wolfidan/callisto/output/nightscan/scan-results/full-sky-scan_interpolated_2025-04-20.png

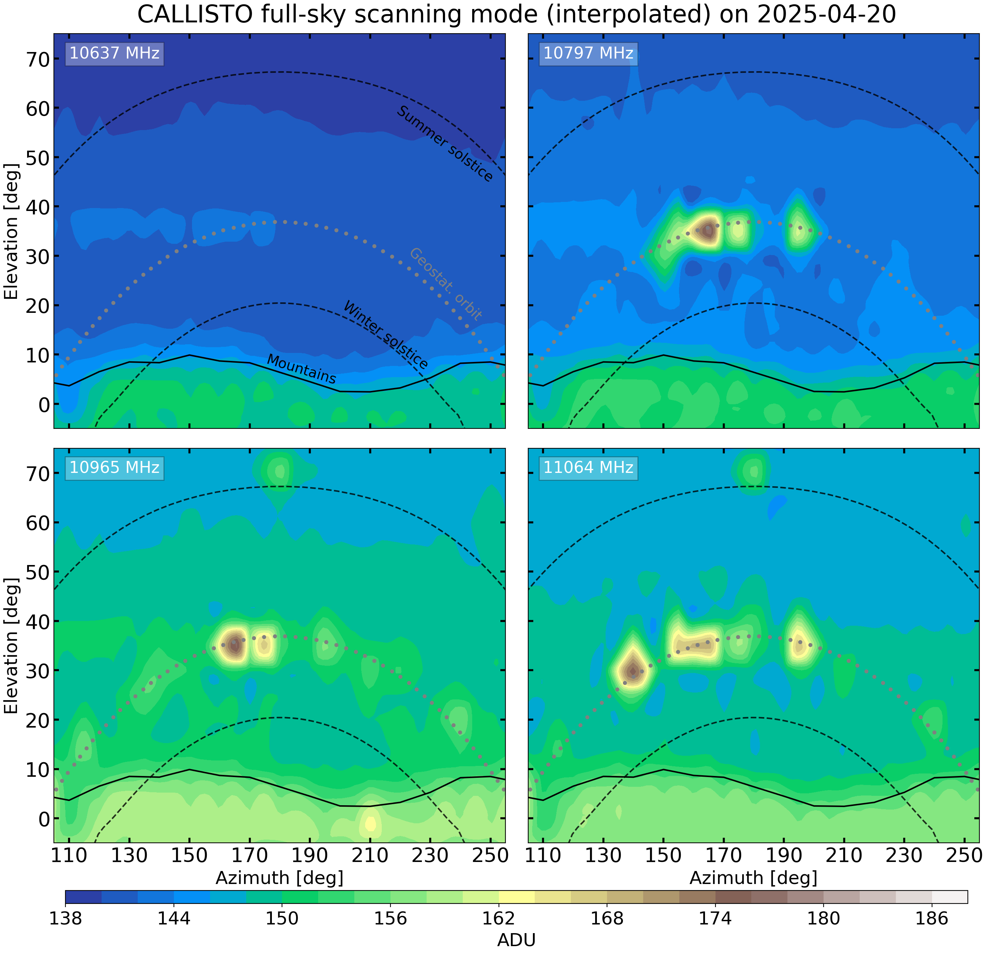
output/nightscan/scan-results/full-sky-scan_interpolated_2025-04-20.png
