wolfidan/callisto/readme.md

# X-band Radio Telescope (XRT) in Locarno-Monti: CALLISTO spectrometer for solar flux monitoring

A forthcoming scientific publication will address the main aspects of the instrument's capabilities and performance.
