wolfidan/callisto/doc/Documents/computerstuff.docx

# Computer related and other stuff

Computer name: XRT
User name: SwissMeteo
Password: xrt

MS-account: none
OneDrive: not yet enabled

Security questions:
- 1st pets name: Kati
- Childhood nickname: Bruno
- First school: Kurz

Windows updates: Paused until ~20/12/2023; For manual update, close all applications first.

Installed tools:
- Anaconda Python3
- Arduino-Driver
- System Scheduler ssfree.exe
- PUTTY
- ActivePERL
- Java RunTimeSystem
- CALLISTO and related tools (C++ and Python) [CallistoInstaller_V22.zip + Callisto_V125.zip]
- AnyViewer: 719 915 680 password XrT-2023
- AnyDesk: 1 568 878 401 password XrT-2023

Change of autostart: Win R shell:startup

Two times per year change direction for cold sky calibration +/-10°, see path geostationary satellites

Do not forget to check updates and to restart computer including CALLISTO

In case last FIT-file of the day is not complete, delete it. Otherwise calibration process may die

Do not forget to backup applications and system
