wolfidan/callisto/doc/Documents/SatFinderOrNotSatFinder.pptx

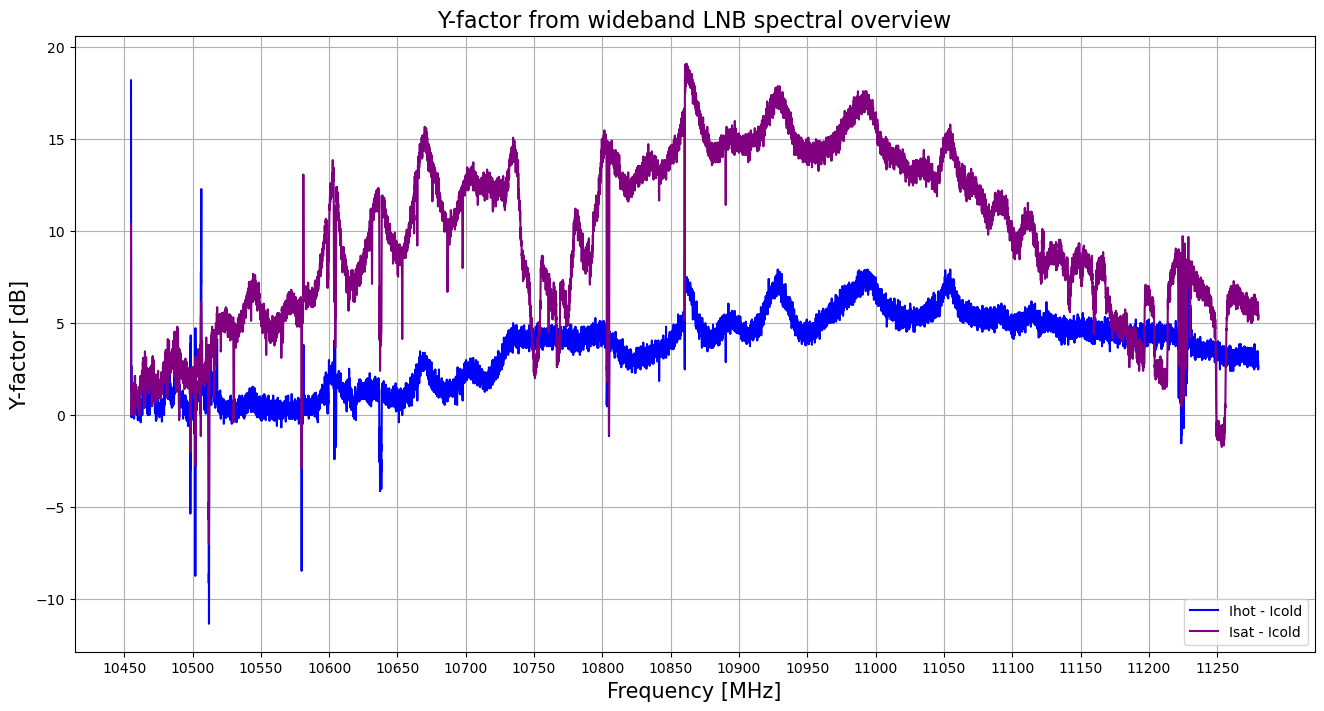
[picture p3: figure]
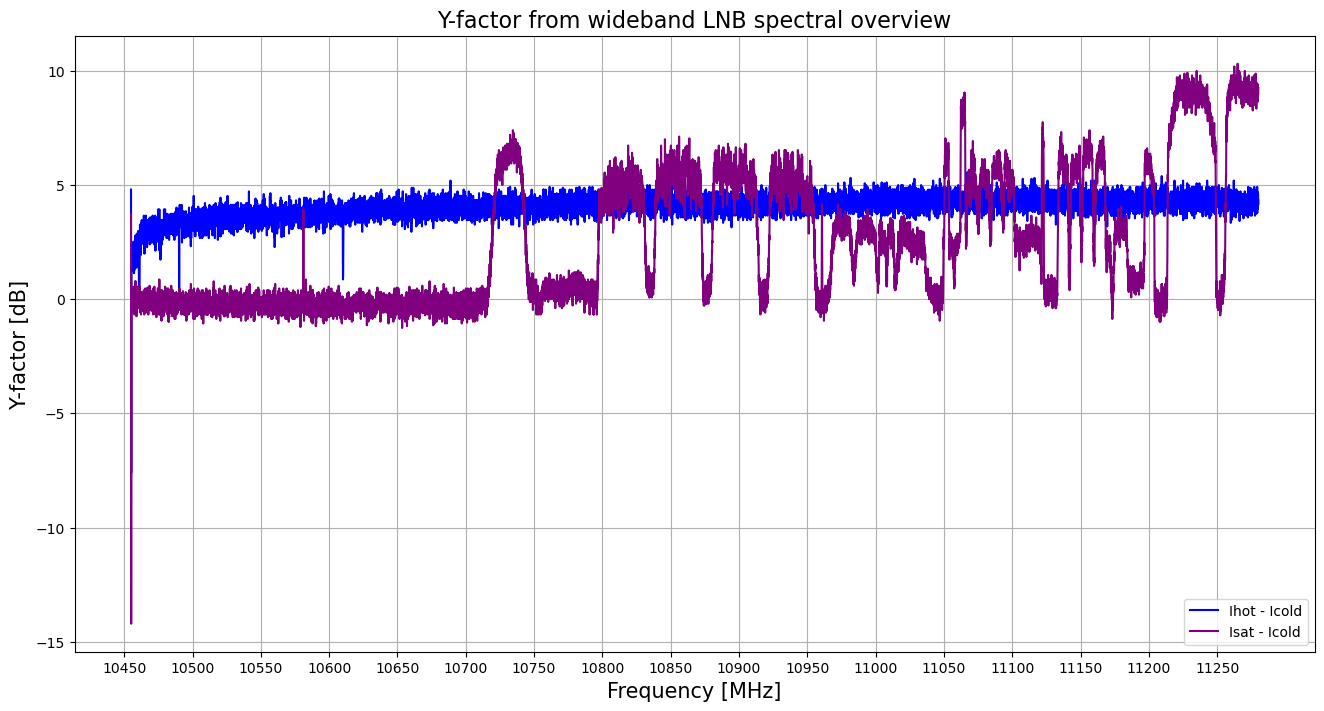
[picture p4: figure]
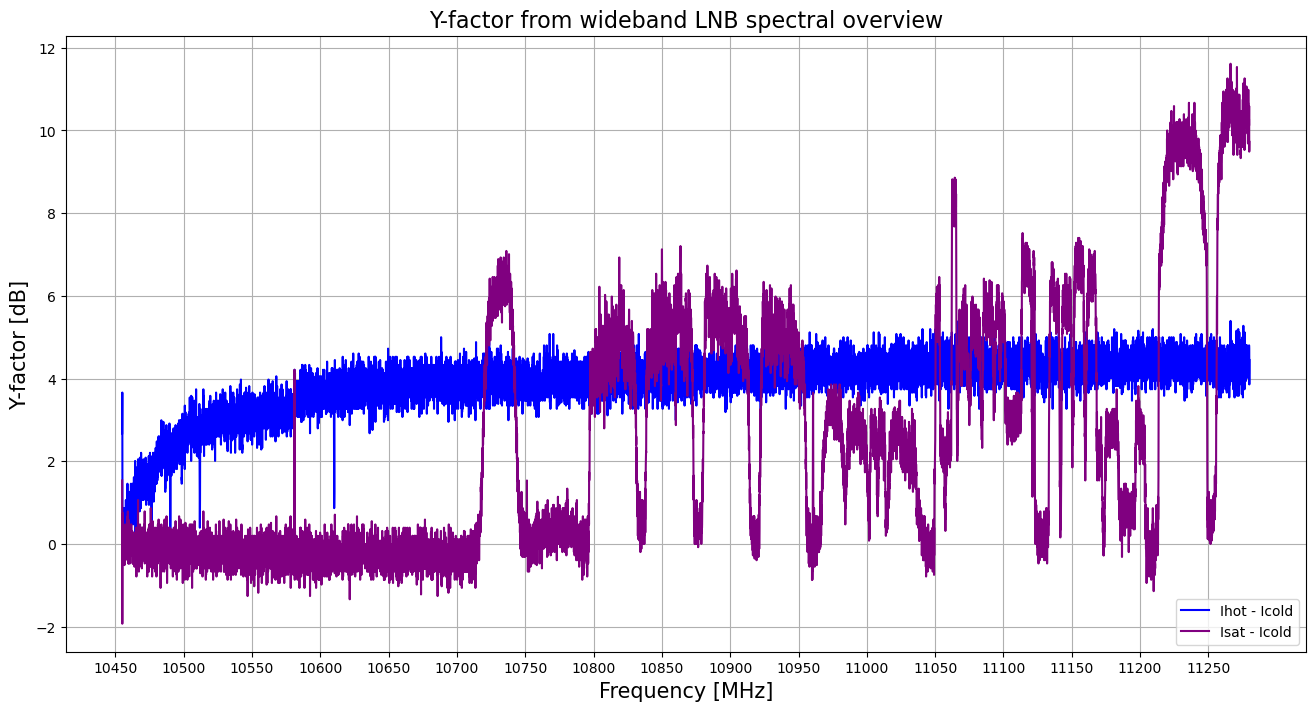
[picture p5: figure]

With SAT-Finder, gain 122d No SAT-Finder, gain 82d No SAT-Finder, gain 82d, -10 dB ATT

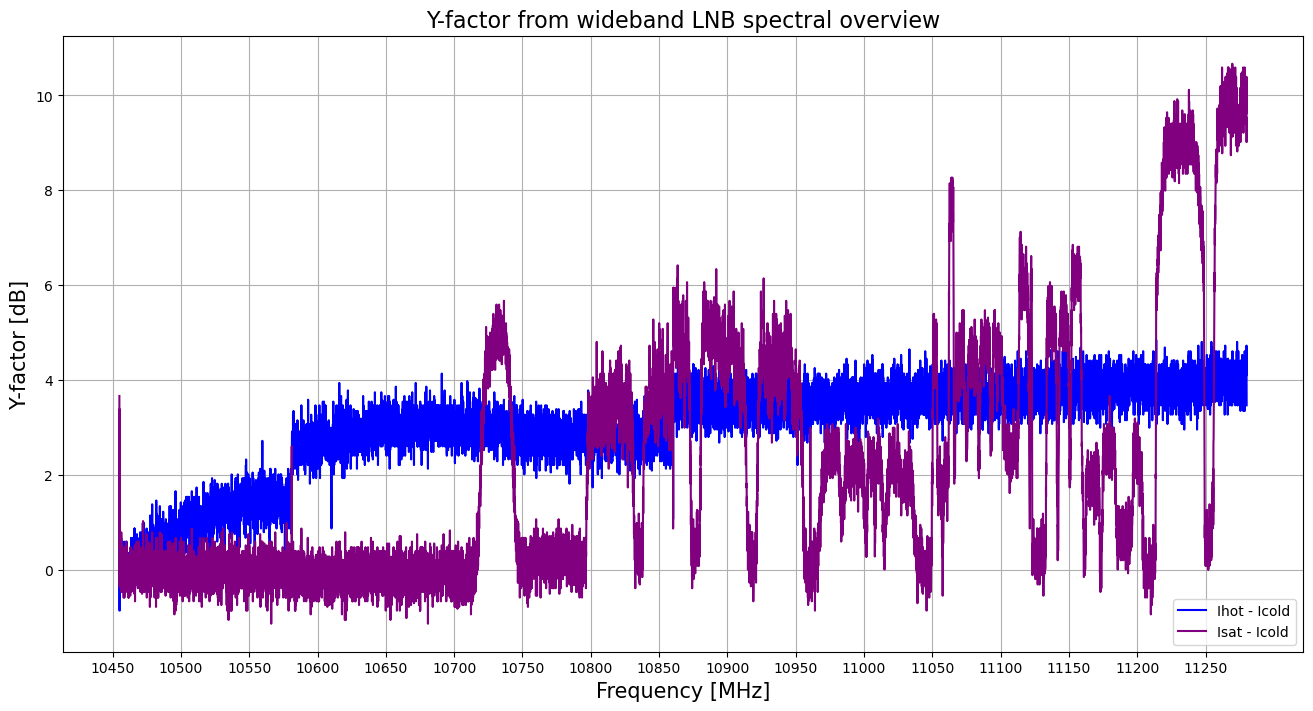
[picture p6: figure]
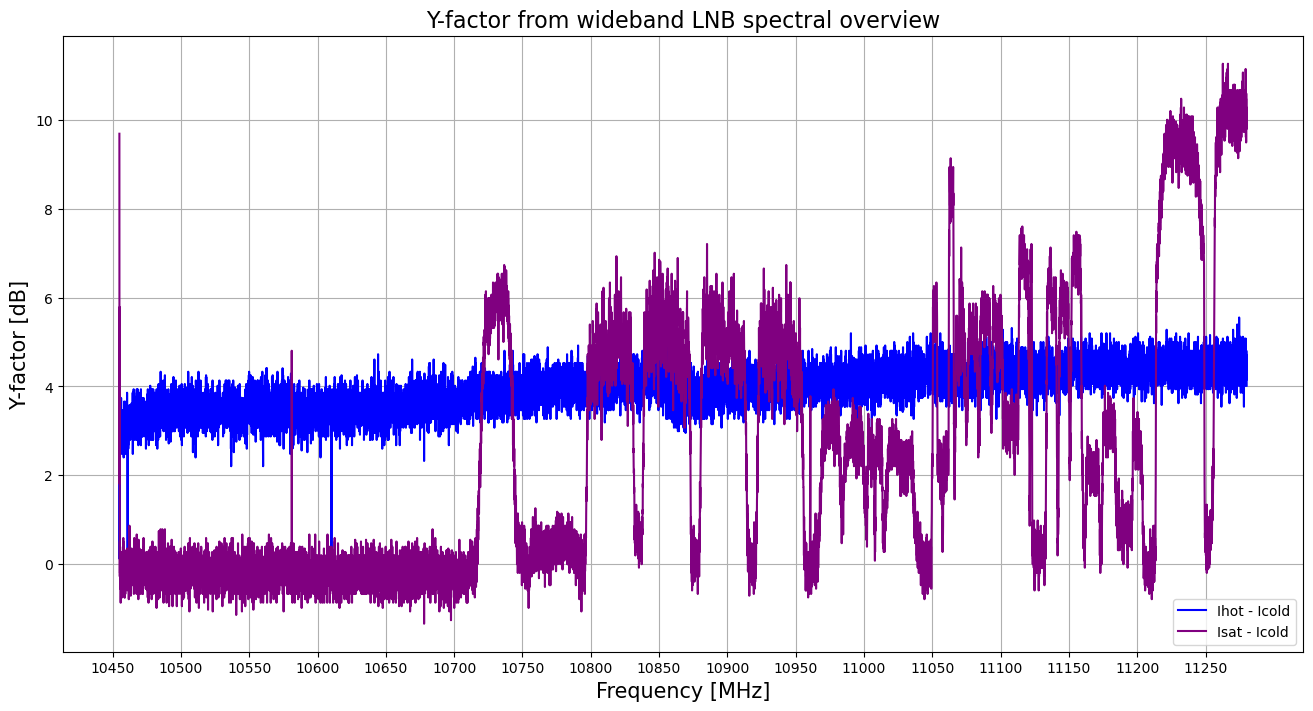
[picture p7: figure]

SAT-Finder advantage:
Higher Y-factor
SAT-Finder disadvantage:
Only at dedicated frequencies
No SAT-Finder advantage:
Flat spectrum
No SAT-Finder disadvantage:
Lower Y-factor

No SAT-Finder, gain 82d, -20 dB ATT No SAT-Finder, gain 123d, -20 dB ATT

Y-factor Sky-Ground in blue, Y-factor Satellite-Ground in purple

## Slide 2

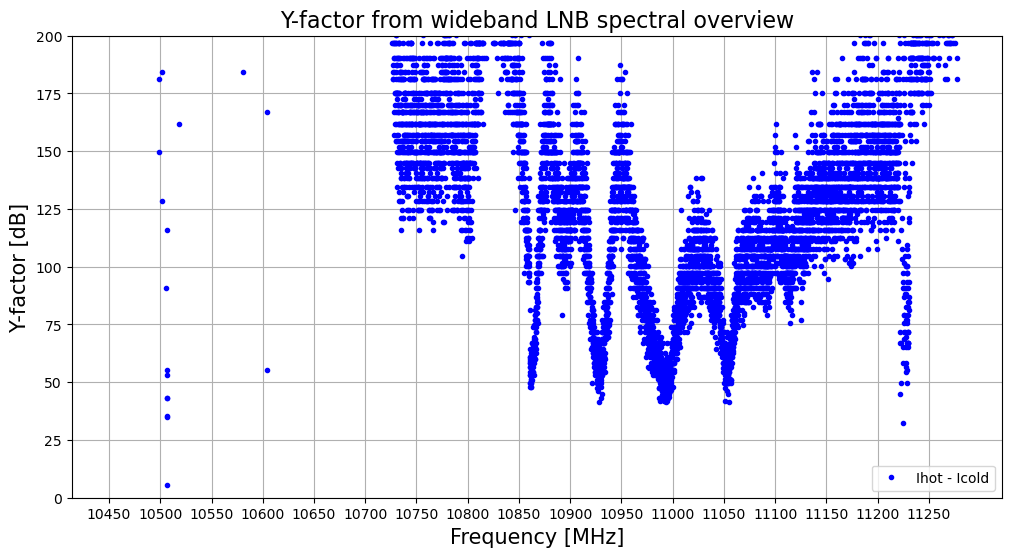
[picture p8: figure]
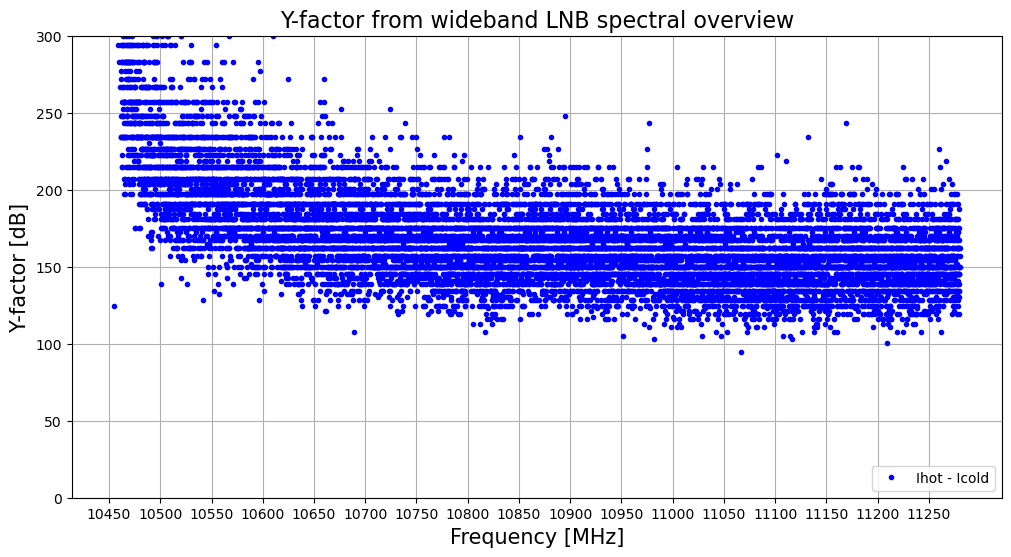
[picture p9: figure]
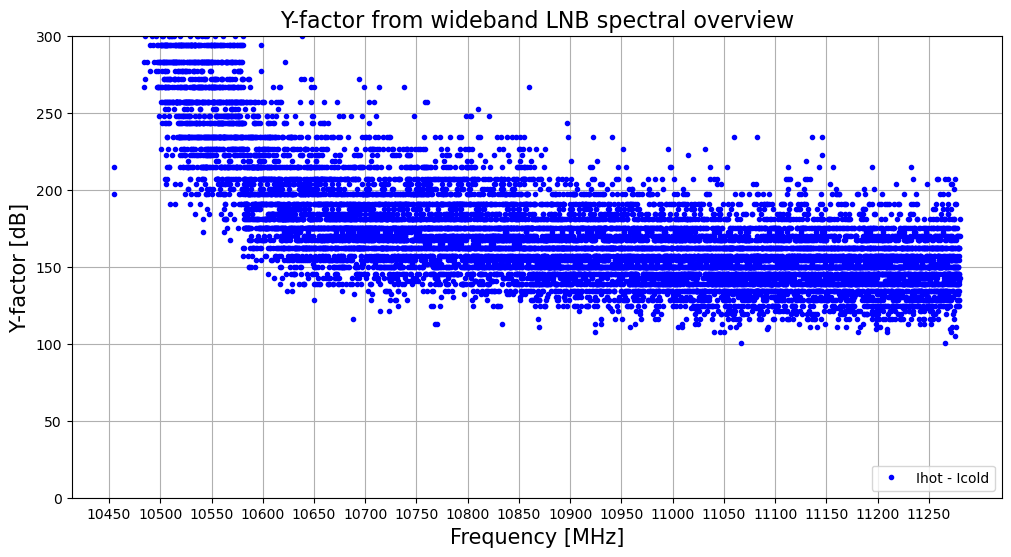
[picture p10: figure]

With SAT-Finder, gain 122d No SAT-Finder, gain 82d No SAT-Finder, gain 82d, -10 dB ATT

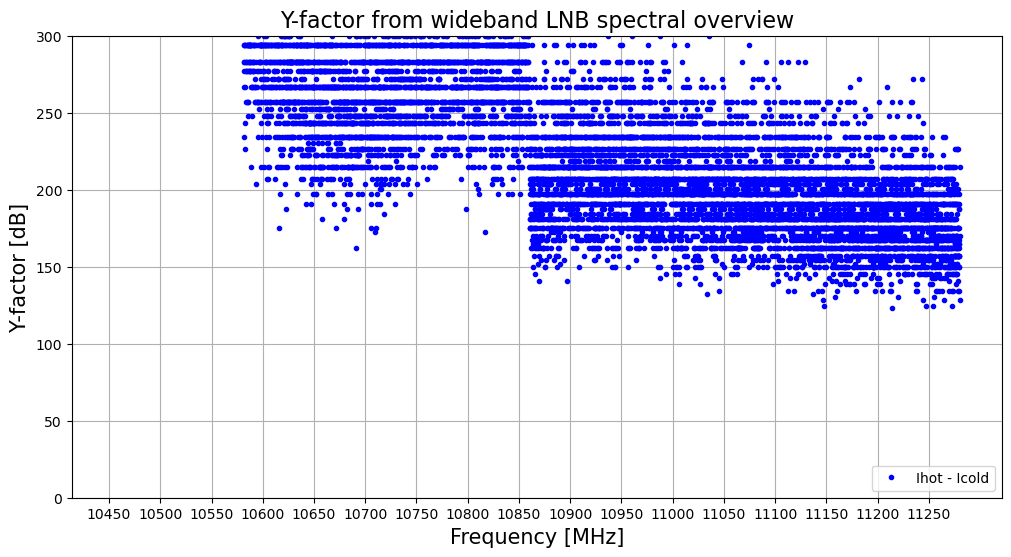
[picture p11: figure]
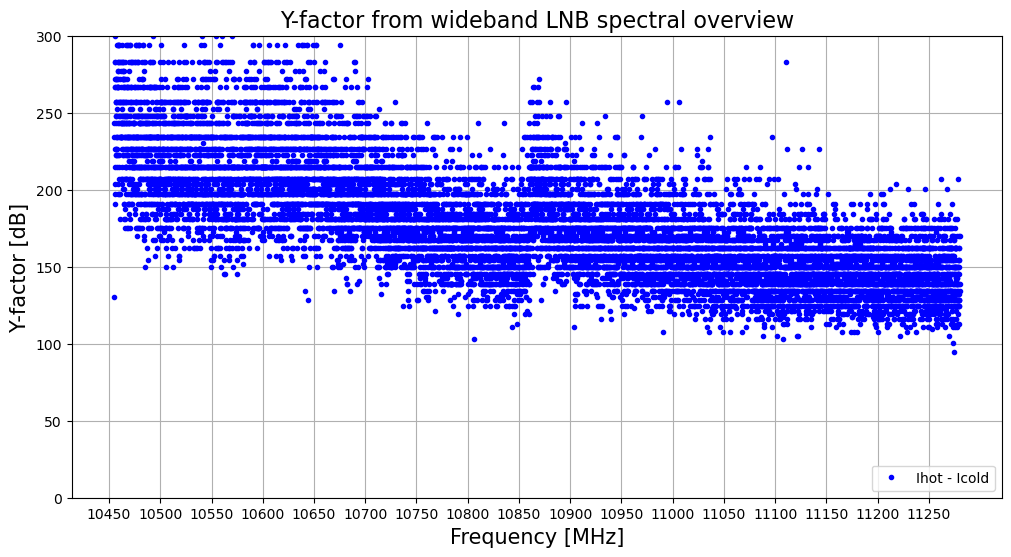
[picture p12: figure]

Instrument noise temperature
Is best WITH SAT-Finder,
although only at dedicated frequencies
Which need to be found out for a
specific configuration.

No SAT-Finder, gain 82d, -20 dB ATT No SAT-Finder, gain 123d, -20 dB ATT

System temperature: Sky/Ground
