wolfidan/callisto/scripts/control/moontracking/configmoon.docx

# Description of the configuration file/parameter configmoon.ini

The file shown below contains all variables and constants required in the Python script moonpos_AZI_ELE.py. File shall be edited with a simple ASCII-Editor such as notepad.

#
# Configuration file for python sun-tracker
# Author: Chr. Monstein
# Date: 2023-08-24
# Do not add comments at the end of any parameter!
#
#------------------------------------------------------------------------------

# Location parameter

[Location]

longitude = 8.755948 # Longitude of telescope in decimal degree, positive east
latitude = 47.20329 # Latitude of telescope in decimal degree, positive north
elevation = 414 # Elevation of telescope above sea-level in meters
temperature = 32 # Ambient temperature in Celsius degree to compensate refraction
pressure = 900 # Atmospheric pressure to compensate refraction in mbar

# Tracker parameter (rotors and interface)

[Tracker]

MaxRange = 77 # Maximum and fixed range of the rotor as +/-, in total 154°
AziMin = 80.0 # Minimum azimuth to avoid obstructions in the east, such as neighbor’s house
AziMax = 250.0 # Maximum azimuth to avoid obstructions in the west, such as neighbor’s house
EleMin = -12.0 # Lowest elevation, usually required for ground calibration Thot of about 300 kelvin
EleMax = 90.0 # Highest elevation which one wants to reach, usually for sleeping position in zenith
AziPark = 180.0 # Azimuth of telescope in sleeping mode during the night. Can be used to observe the Moon or the Sun in transit mode
ElePark = 90.0 # Elevation of telescope in sleeping mode during night. Can be used to observe the Moon or the Sun in transit mode

aziref = 165.7 # Azimuth reference, depends on observing window, usually somewhere in the south
eleref = 42.5 # Elevation reference, depends on observing mode, usually below track of the sun

azidir = -1.0 # Direction of rotation azimuth rotor, negative to the east
eledir = 1.0 # Direction of rotation elevation rotor, positive to the zenith

planecorr = 0.0184 # Factor to correct for tilted azimuth plane, ideally 0.0
Correction is performed as a linear approximation:
true_elevation = calculated_elevation – planecorr*azimuth
The factor planecorr can be found by rotating azimuth from -75° … 75° in steps of ~2° …5° and measuring elevation with a inclinometer. Then put azimuth and elevation into EXECL, add linear plot and remember gradient. If east is higher in elevation than west, then gradient planecorr is > 0.

MyComport = COM13 # Communication port via USB, use device manager to find out. Arduino driver required

# Calibration related parameter

[Calibration]
EleGnd = -8.0 # Position slightly below horizon to get Thot of about 300 kelvin
dEleCali = -10.0 # Deviation from sun-tack to get cold sky for calibration of about 12 kelvin

# Swiching parameter

[TelescopeSwitching]

Hot = 0,1,2,15,16,17,30,31,32,45,46,47 # AT those minutes, telescope moves to ground (~300 kelvin)

Cold = 3,4,5, 9,10,11,18,19,20,24,25,26,33,34,35,39,40,41,48,49,50,54,55,56 # A few degree below moon to get cold sky (~12 kelvin)

Src = 6,7,8,12,13,14,21,22,23,27,28,29,36,37,38,42,43,44,51,52,53,57,58,59 # Telescope tracks moon
Do not add more values as it takes time to scan and we have only 60 minutes available for the whole scan until the next scan is triggered via system scheduler ssfree.exe (or via crontab).
