wolfidan/callisto/doc/Documents/datagram.pptx

Datagram CALLISTO

Option:
do.bat + ftp-gz.pl
upload to FHNW

callisto.cfg
scheduler.cfg

ssfree.exe
Every 15 min.

Callisto.exe
C++

Java Viewer or
RappViewer or FV.exe
Manual operation

PlottAndCalibratefromFIT-loop.py

PlottAndCalibrateLC-4Hz.py

Real time

15 minutes

*.fit

On request

OVS*.prn

10…40 sec

LC*.txt

LOG*.txt

Callisto-gain-sweep.py
ReadPlot:OVS.py

Notepad, Excel,
Wordpad, …

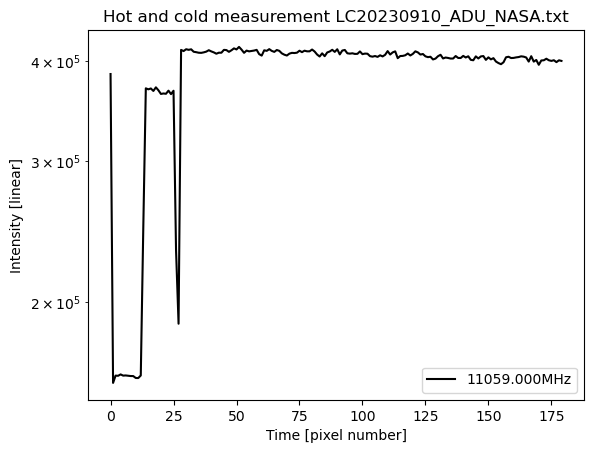
[picture p28: figure]
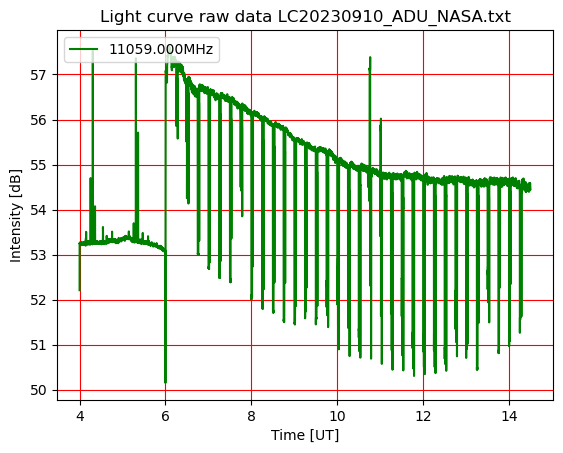
[picture p29: figure]
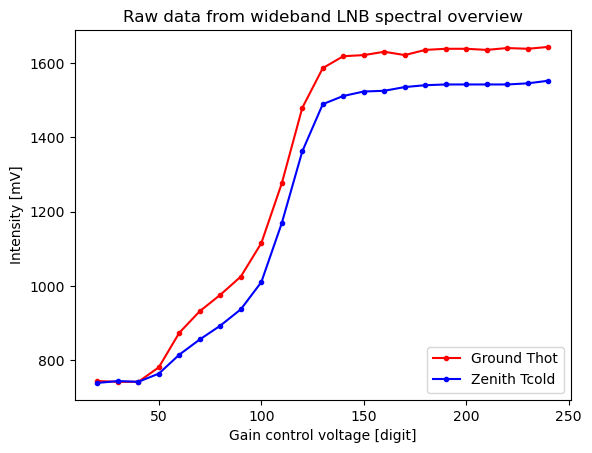
[picture p30: figure]

## Slide 2

Datagram DiSEqC Tracker

configsun.ini or
configmoon.ini

sunpos_AZI_ELE.py
or
moonpos_AZI_ELE.py

ssfree.exe
Every minute

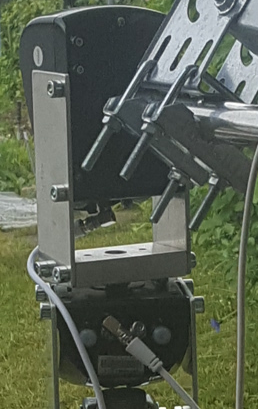
[picture p31: figure]

USB

DiSEqC
interface

PlotDiSEqC.py

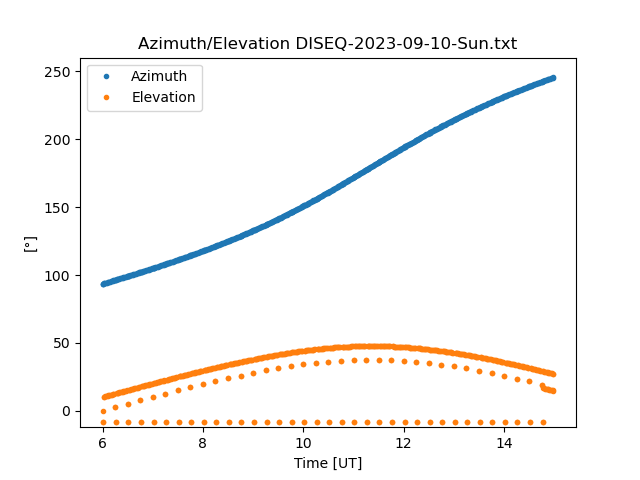
[picture p32: figure]

DISEQC*.txt

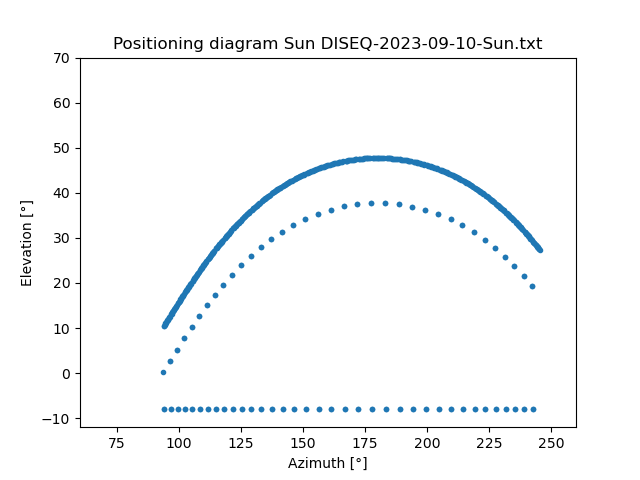
[picture p33: figure]
