wolfidan/callisto/scripts/control/suntracking/Python calls in System Scheduler ssfree.docx

Python calls in System Scheduler ssfree.exe

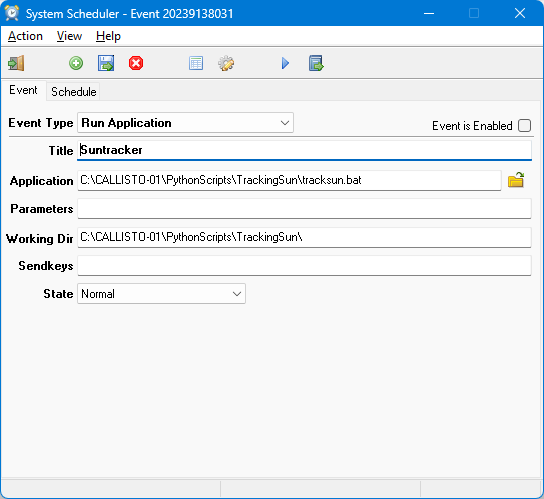
[picture p34: figure]
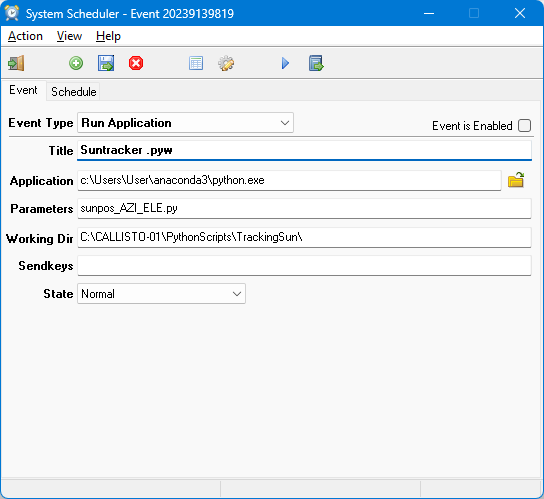
[picture p35: figure]
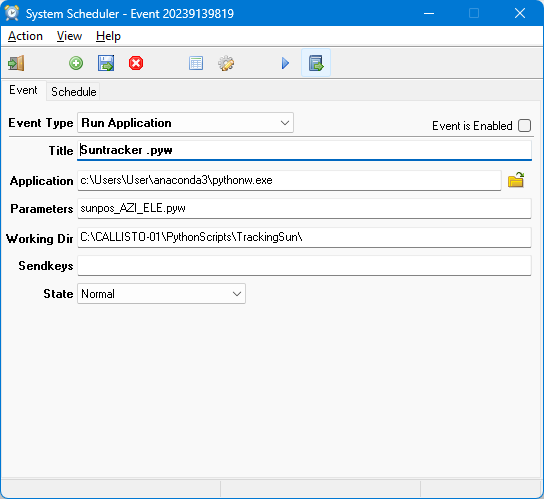
[picture p36: figure]
