wolfidan/callisto/doc/Screenshot_callisto_installation.png

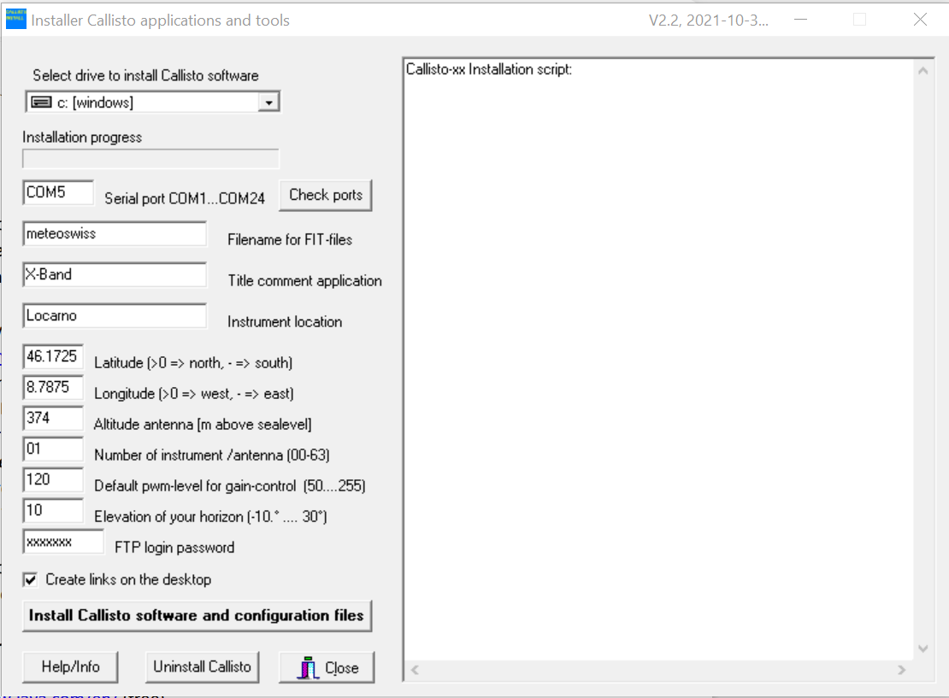
doc/Screenshot_callisto_installation.png
