wolfidan/callisto/doc/calibration/table_pointing-offsets.csv

# table listing the pointing offsets estimated by checking the maximum of the
# solar flux with callisto.
# The table includes the following entries:
# - datetime: date and time measured in UT
# - phi_sky & delta_sky [deg.]: azimut and elevation angles with the sky reference system
# - aziref & eleref [deg.]: azimut and elevation angles with the rotor reference system
# - sigma_azi & sigma_ele [deg.]: one sigma tolerance for aziref and eleref
# - freq [MHz]: at which the pointing offsets have been estimated
datetime_UT | phi_sky | delta_sky | aziref | eleref | sigma_azi | sigma_ele | freq
2024-12-03T12:53 | 203.9 | 18.12 | 181.3 | 60.2 | 0.5 | 0.2 | 609.875
2024-12-03T14:39 | 203.9 | 18.12 | 181.3 | 60.2 | 0.5 | 0.2 | 609.875
2024-12-04T09:50 | 158.7 | 18.74 | 181.6 | 59.6 | 0.3 | 0.2 | 609.875
2024-12-09T09:50 | 158.7 | 18.74 | 181.6 | 59.6 | 0.5 | 0.3 | 609.875
2024-12-09T11:33 | 158.7 | 18.74 | 181.6 | 59.6 | 0.5 | 0.3 | 609.875
2024-12-09T15:35 | 158.7 | 18.74 | 181.6 | 59.6 | 0.5 | 0.3 | 609.875
2025-03-03T14:45 | 158.7 | 18.74 | 181.0 | 60.8 | 0.5 | 0.3 | 10640
2025-03-05T14:30 | 158.7 | 18.74 | 181.5 | 60.3 | 0.5 | 0.3 | 10640
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
