wolfidan/callisto/doc/calibration/Tcold/Tcold_look_up_table.csv

# Atmospheric noise temperature [K] values for the Tcold measures
# These values have been taken from here
# https://descanso.jpl.nasa.gov/propagation/Ka_Band/JPL-D32584_1.pdf
# The Tcold value depends on the atmospheric condisions | such as clouds | atmospheric
# gasses | rain | and so on. Therefore | here we use these tabulated values to apply a first
# order correction (rather than the fixed value at 12 K).
#
# The value of the Tcold temperature depends on the frequency | elevation and the weather
# conditions | therefore in the table we include the following columns
# - freq: frequency in GHz
# - elev: elevation in degrees
# - cond: weather conditions | if 'clear' or 'cloudy'
# - AH: absolute humidity in g/m3
# - CL: columnar liquid in kg/m2
# - Tcold: estimate of the Tcold temperature in K
freq | elev | cond | AH | CL | Tcold
10 | 90 | clear | 15 | 0.5 | 4.7
10 | 90 | cloudy | 15 | 0.5 | 7.33
10 | 45 | clear | 15 | 0.5 | 6.62
10 | 45 | cloudy | 15 | 0.5 | 10.30
10 | 30 | clear | 15 | 0.5 | 9.32
10 | 30 | cloudy | 15 | 0.5 | 14.46
10 | 20 | clear | 15 | 0.5 | 13.52
10 | 20 | cloudy | 15 | 0.5 | 20.89
10 | 10 | clear | 15 | 0.5 | 25.89
10 | 10 | cloudy | 15 | 0.5 | 39.56
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
