wolfidan/callisto/output/nightscan/scan-results/full-sky-scan_2025-03-22.png

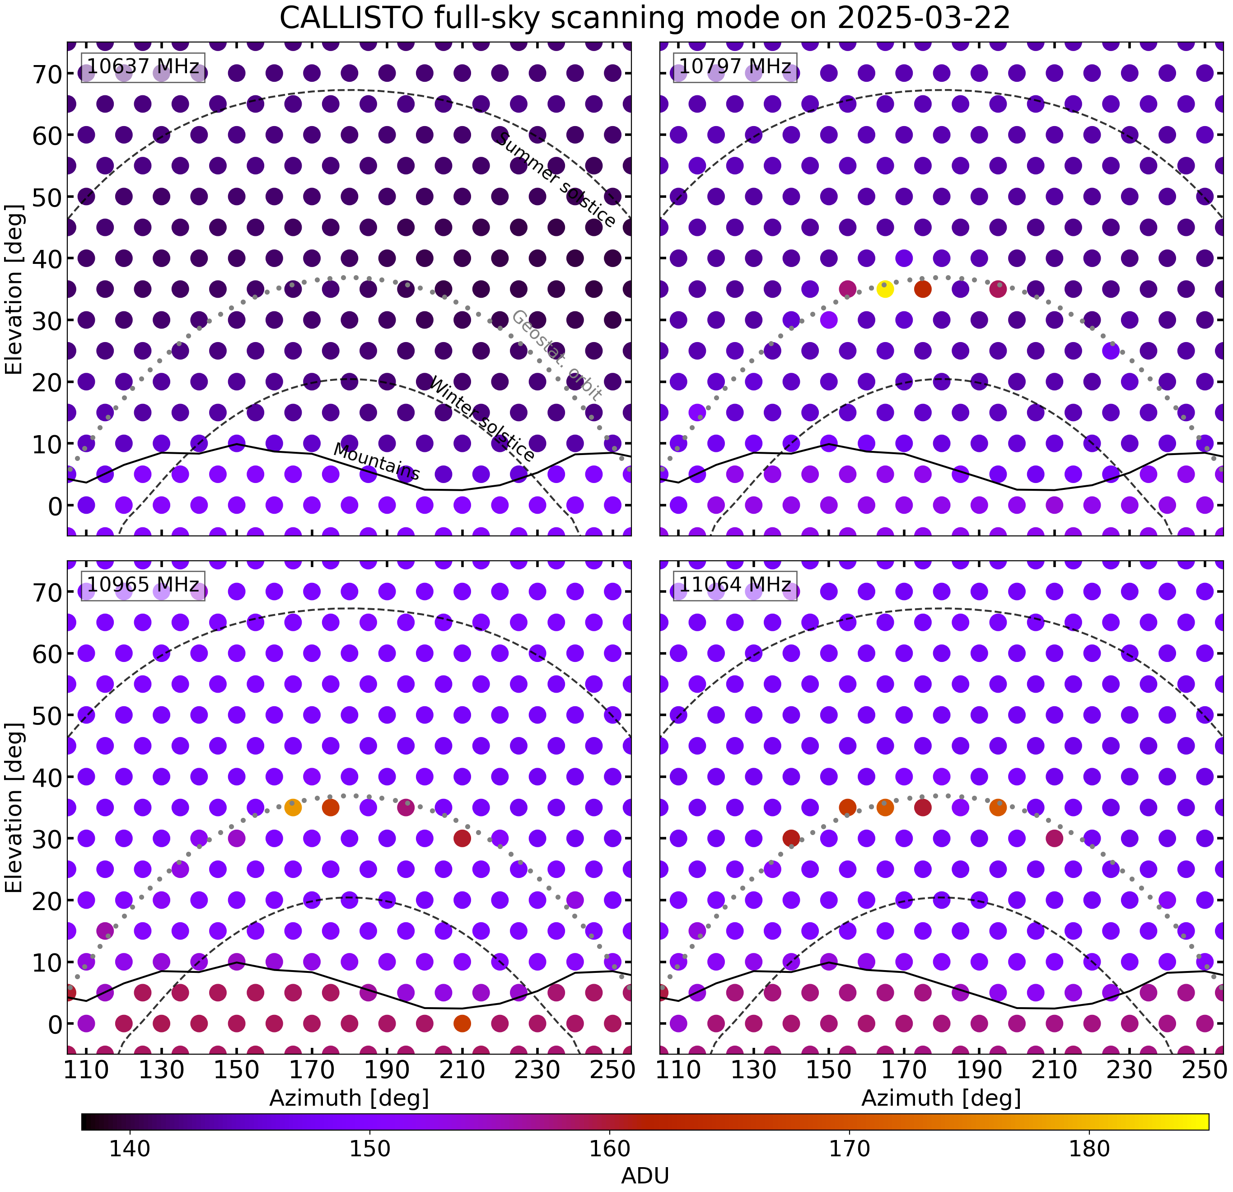
output/nightscan/scan-results/full-sky-scan_2025-03-22.png
