wolfidan/callisto/output/nightscan/scan-results/full-sky-scan_2025-03-24.png

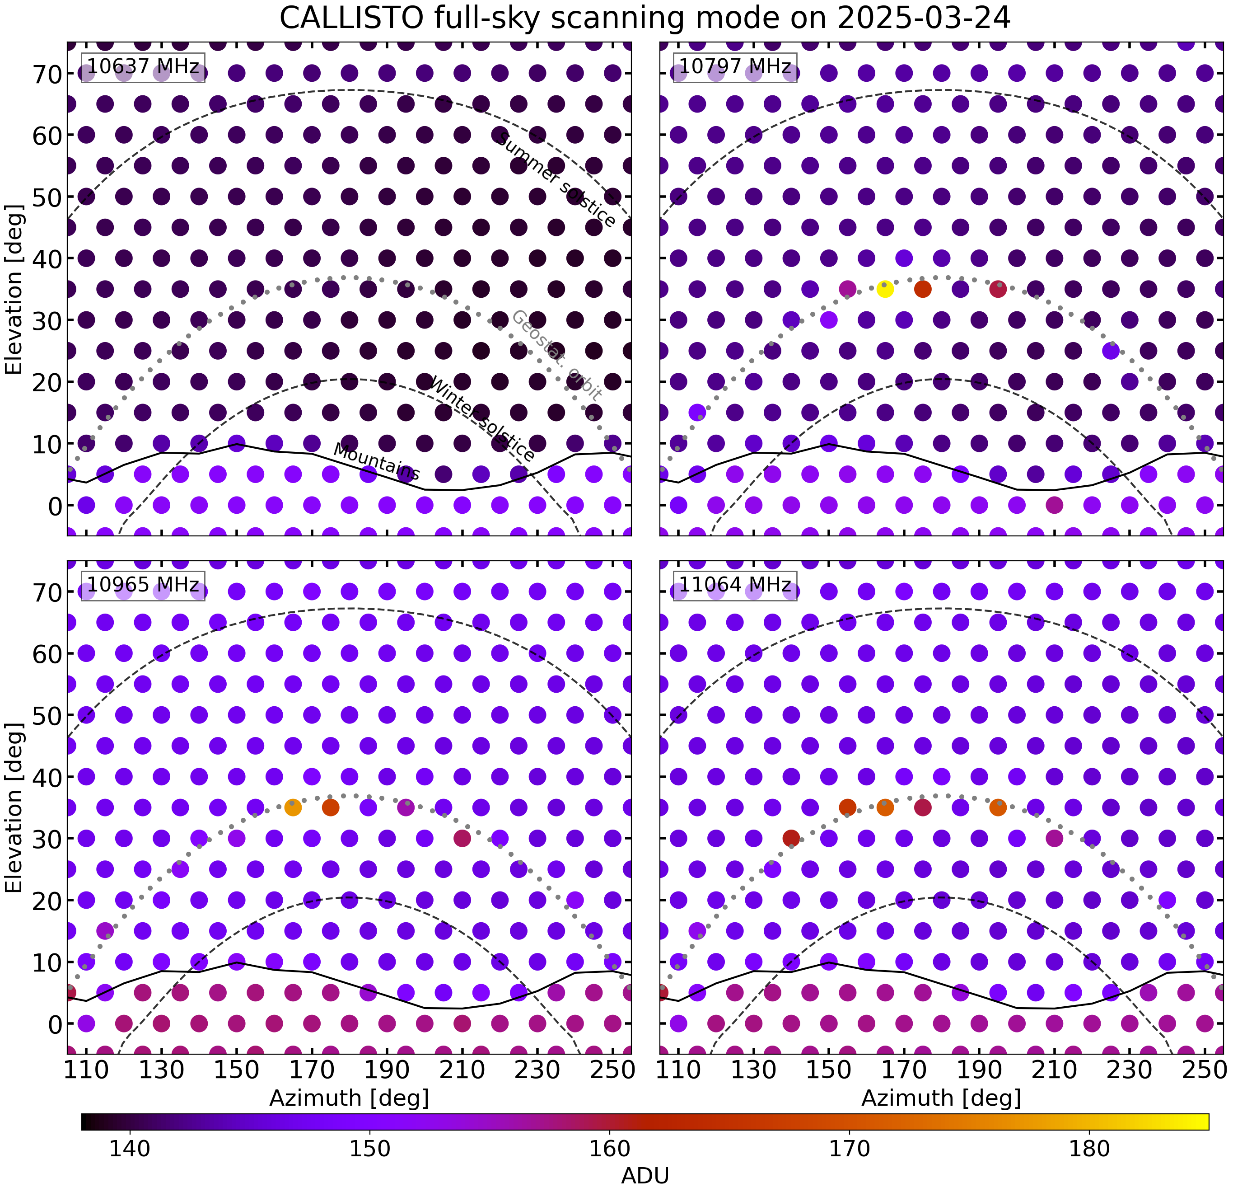
output/nightscan/scan-results/full-sky-scan_2025-03-24.png
