wolfidan/callisto/output/nightscan/scan-results/full-sky-scan_2025-03-26.png

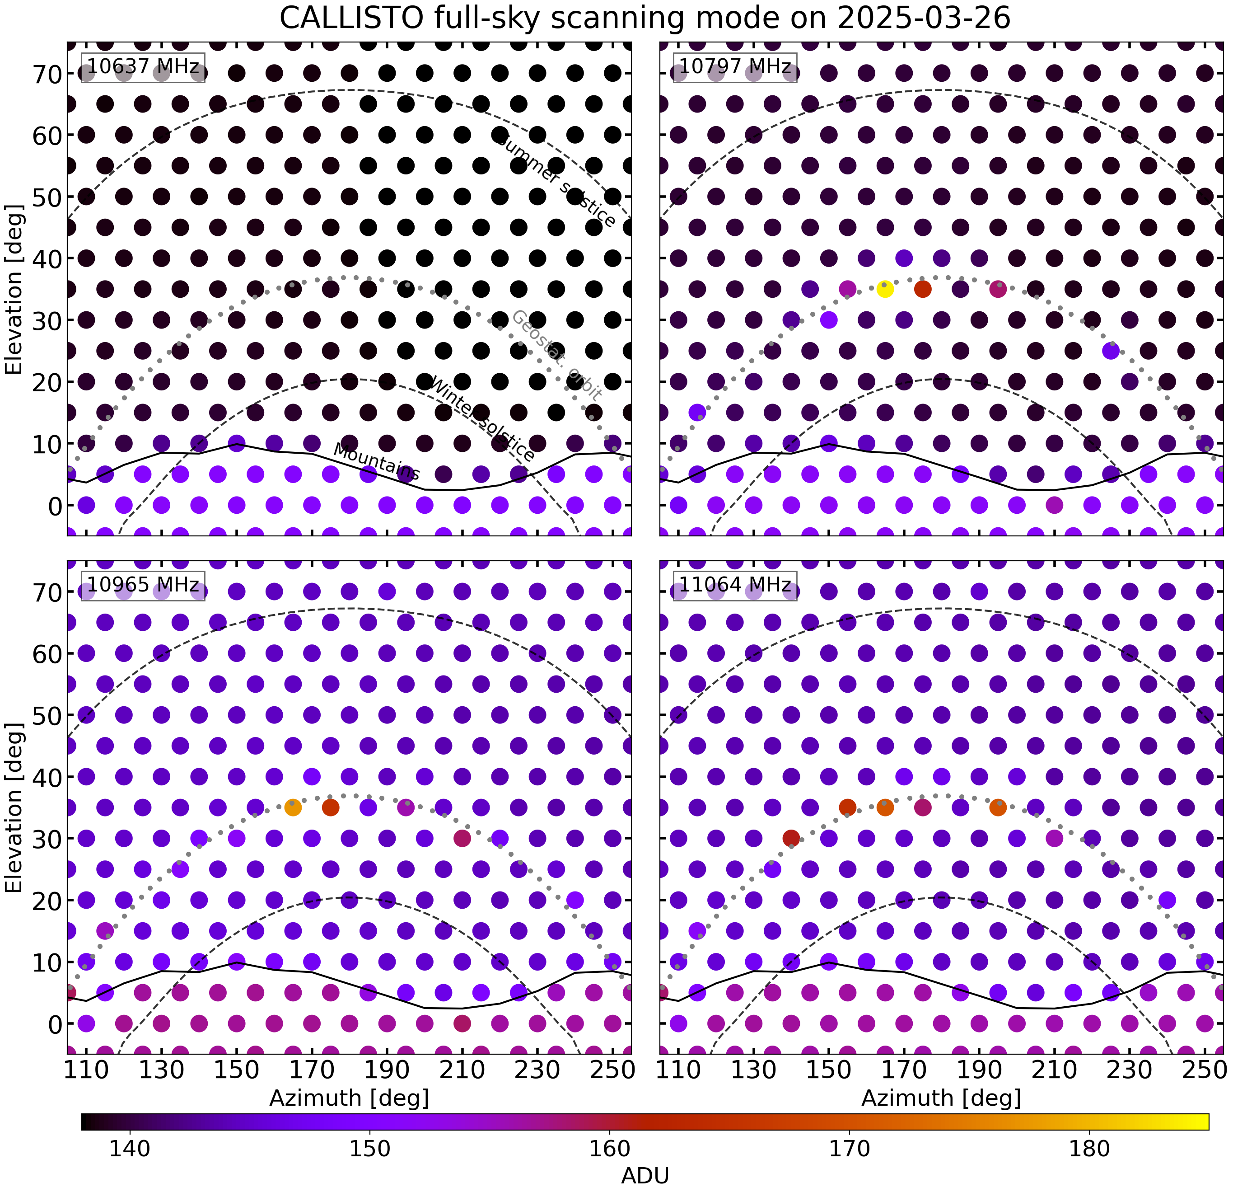
output/nightscan/scan-results/full-sky-scan_2025-03-26.png
