wolfidan/callisto/output/nightscan/scan-results/full-sky-scan_interpolated_2025-03-21.png

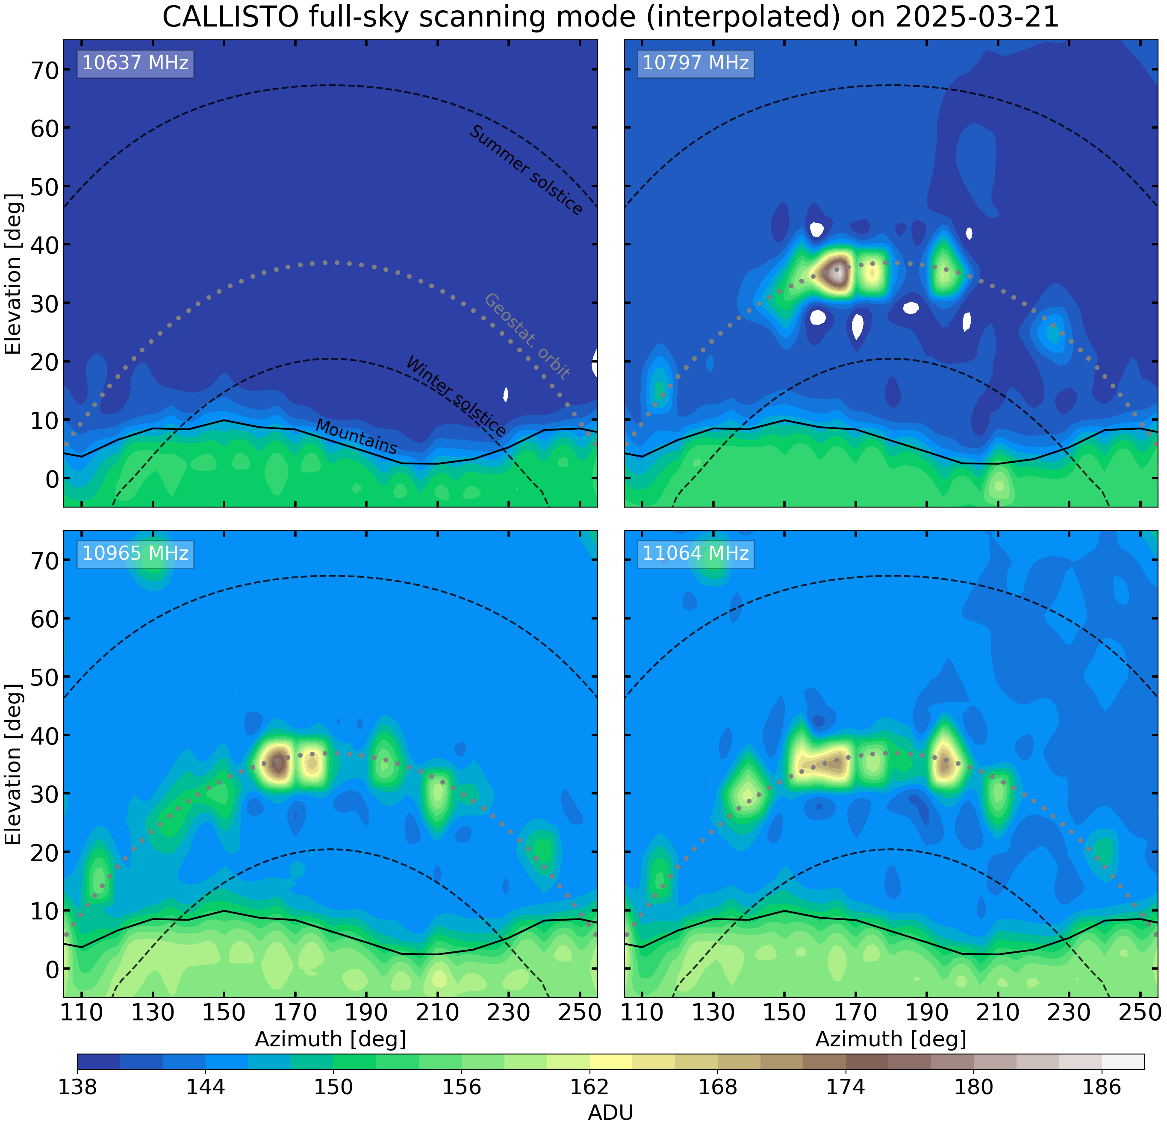
output/nightscan/scan-results/full-sky-scan_interpolated_2025-03-21.png
