wolfidan/callisto/output/nightscan/scan-results/full-sky-scan_interpolated_2025-05-11.png

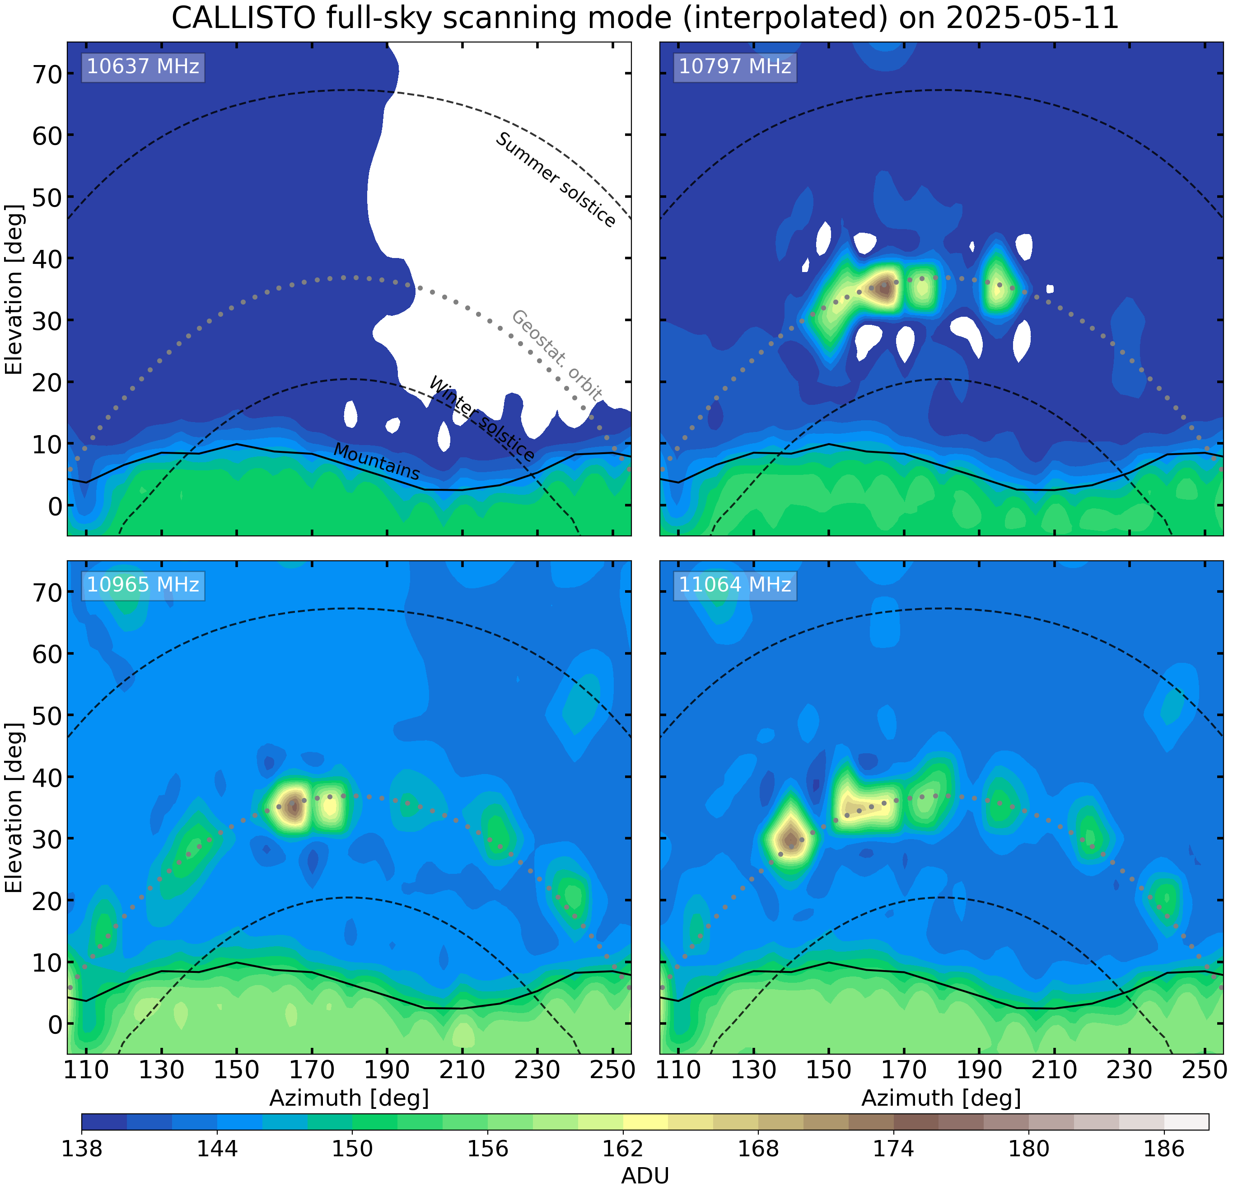
output/nightscan/scan-results/full-sky-scan_interpolated_2025-05-11.png
