wolfidan/callisto/output/nightscan/scan-results/TV-sat-scan_gaussian-fit_2025-03-26.png

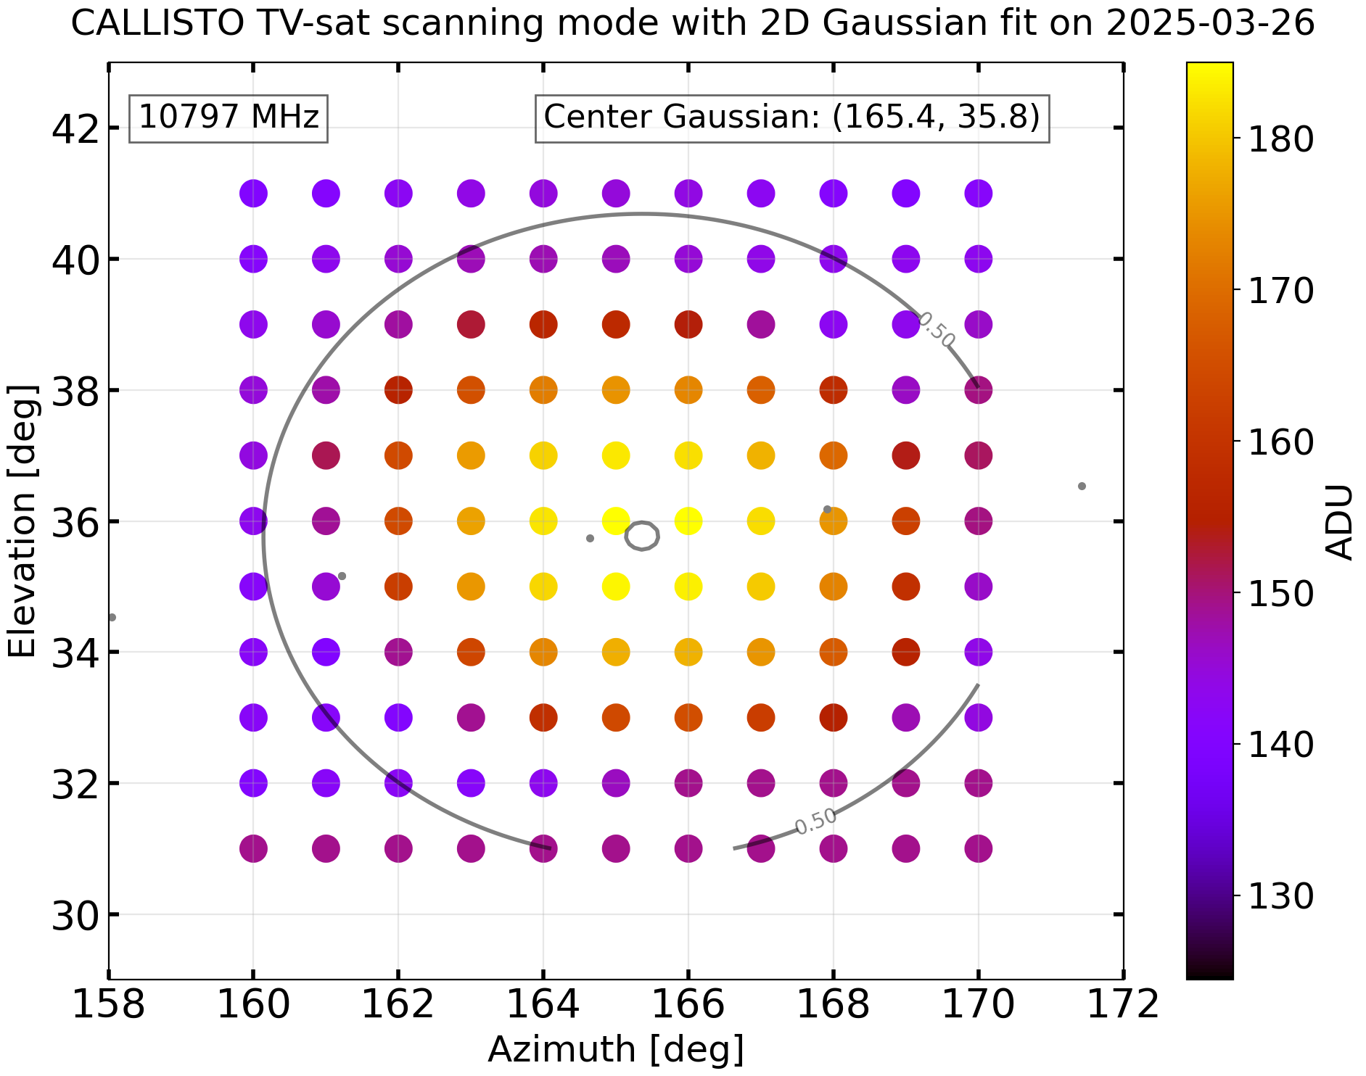
output/nightscan/scan-results/TV-sat-scan_gaussian-fit_2025-03-26.png
