wolfidan/callisto/output/nightscan/scan-results/TV-sat-scan_gaussian-fit_2025-04-04.png

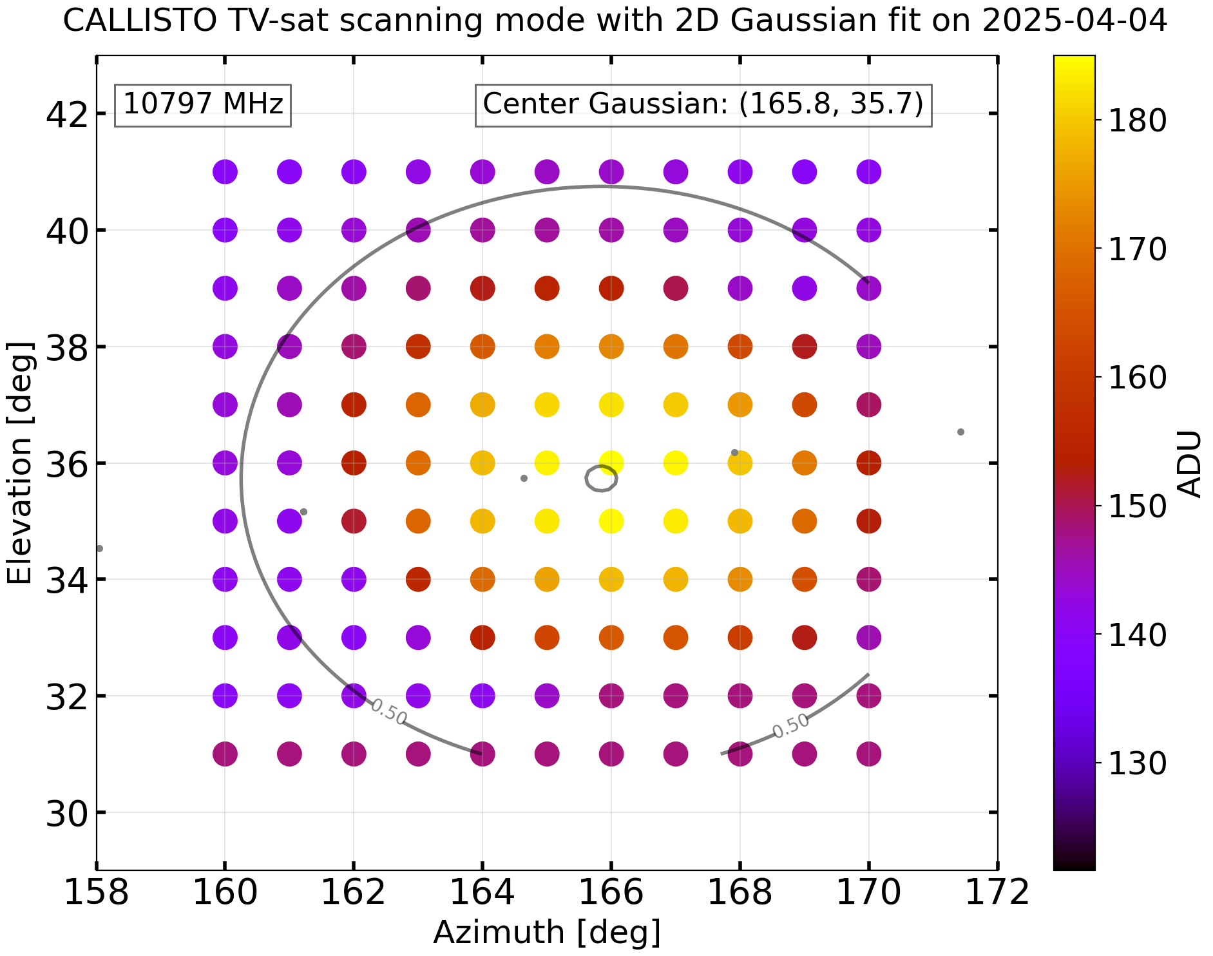
output/nightscan/scan-results/TV-sat-scan_gaussian-fit_2025-04-04.png
