wolfidan/callisto/output/nightscan/scan-results/TV-sat-scan_gaussian-fit_2025-04-05.png

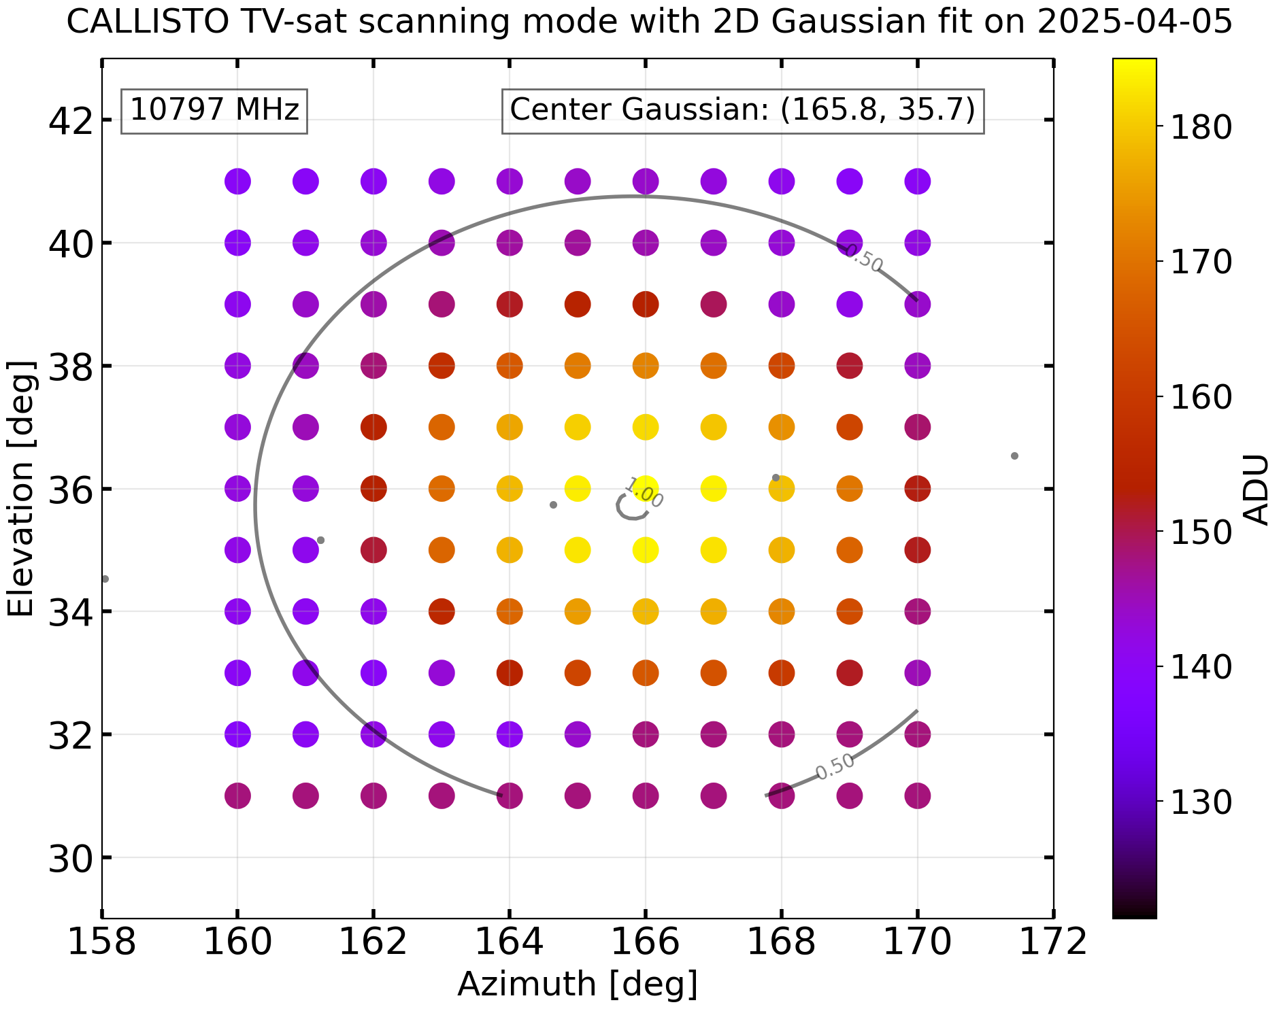
output/nightscan/scan-results/TV-sat-scan_gaussian-fit_2025-04-05.png
