wolfidan/callisto/output/nightscan/scan-results/TV-sat-scan_gaussian-fit_2025-05-05.png

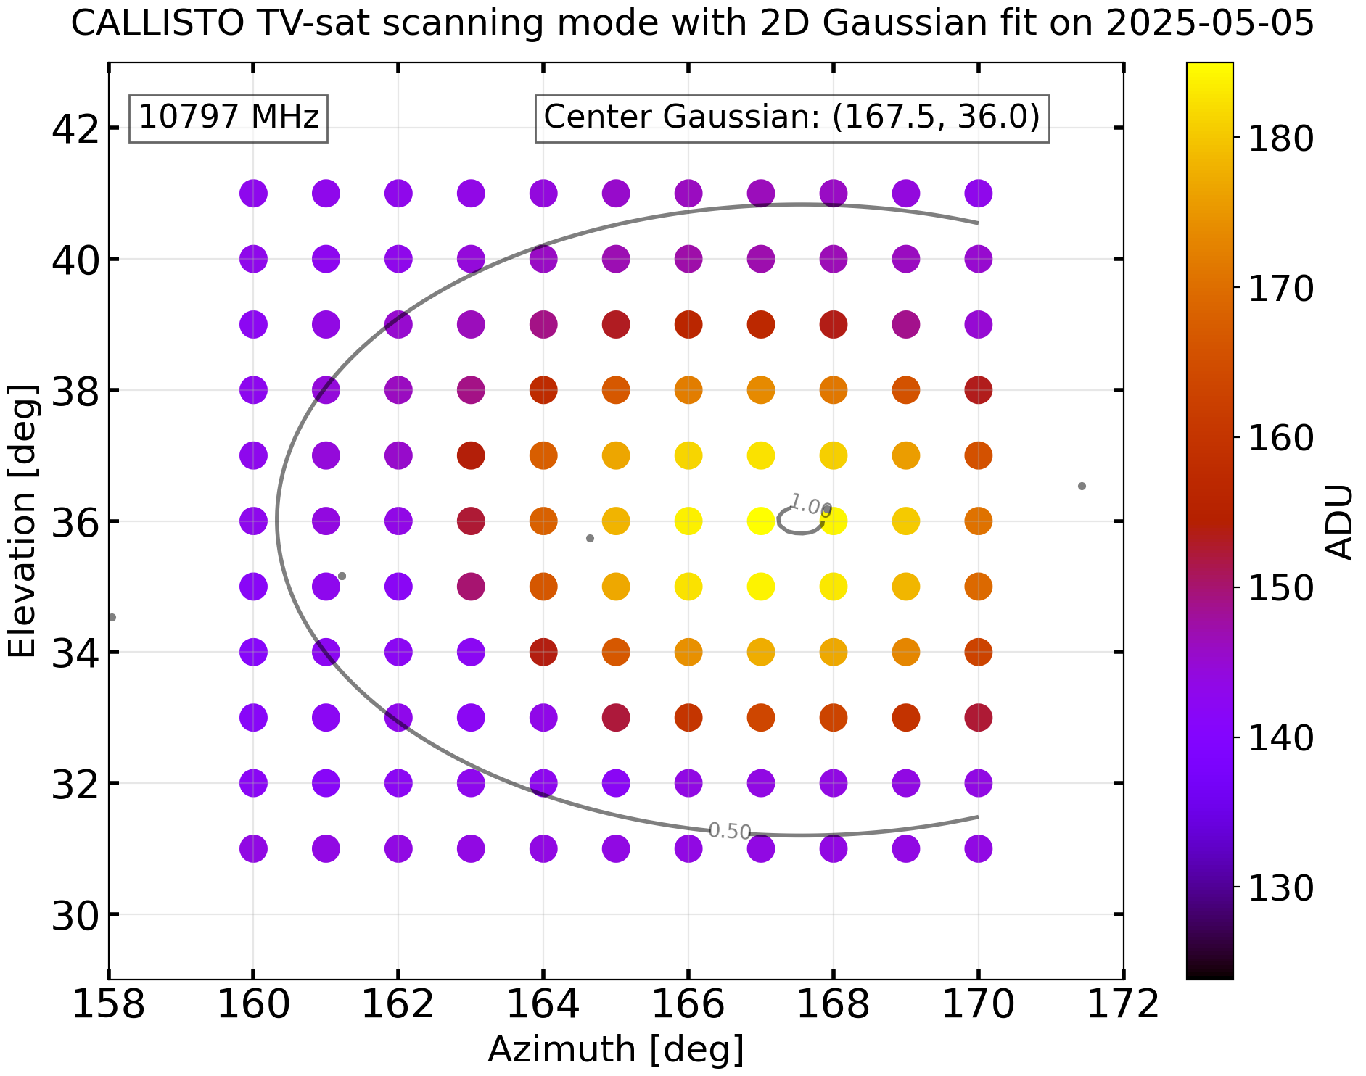
output/nightscan/scan-results/TV-sat-scan_gaussian-fit_2025-05-05.png
