wolfidan/callisto/output/nightscan/scan-results/TV-sat-scan_zoom-in_2025-03-26.png

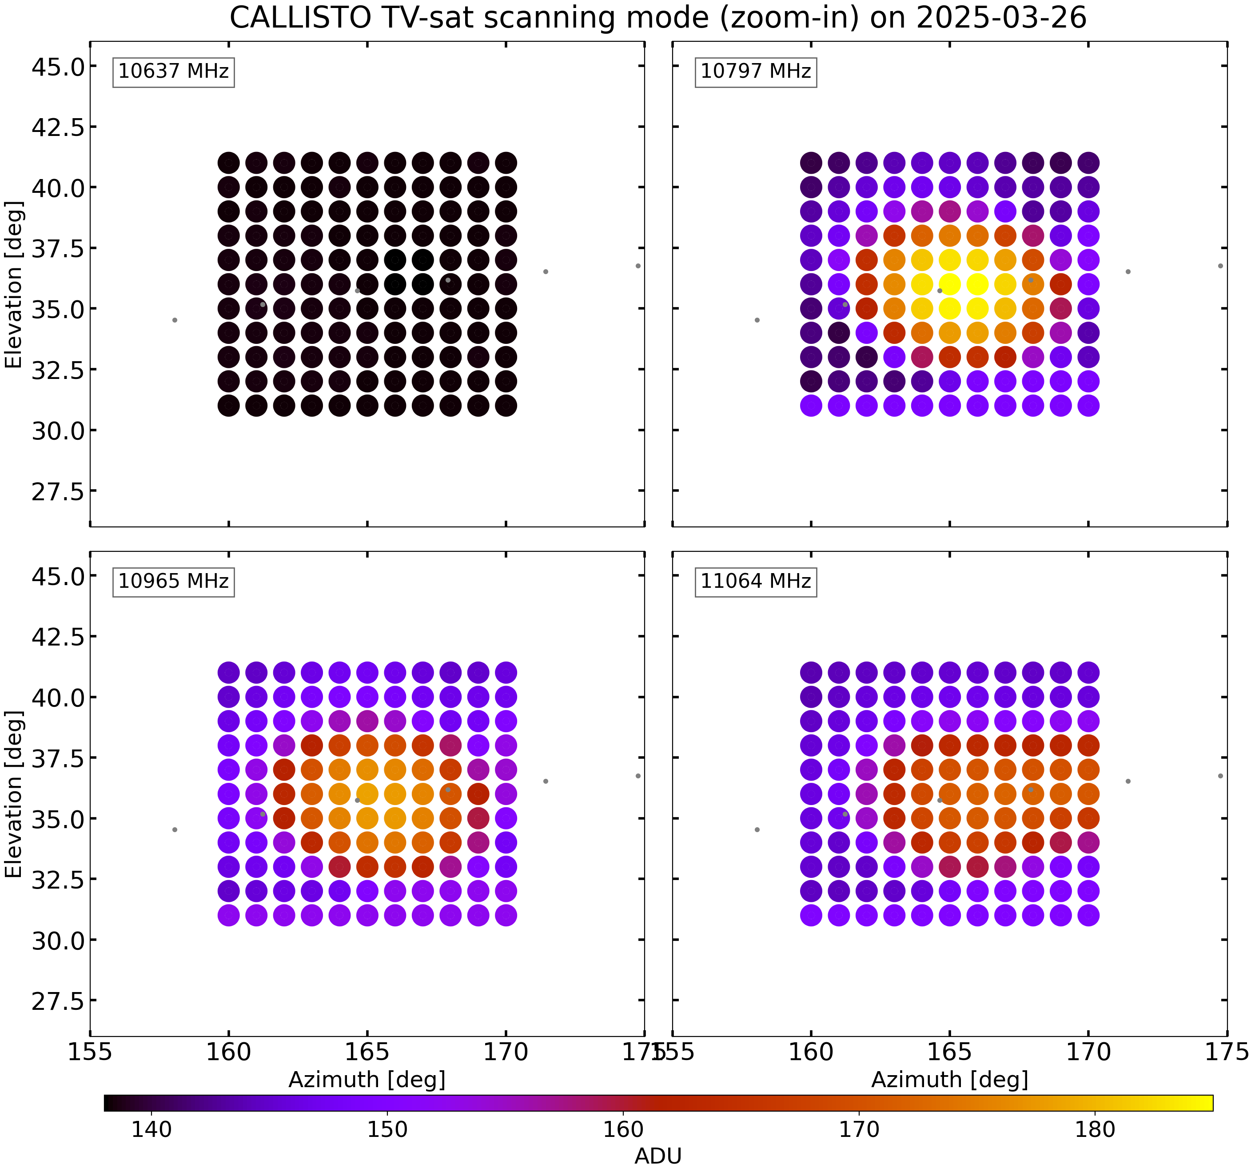
output/nightscan/scan-results/TV-sat-scan_zoom-in_2025-03-26.png
