wolfidan/callisto/output/nightscan/scan-results/zenith-ground-scan_2025-03-26.png

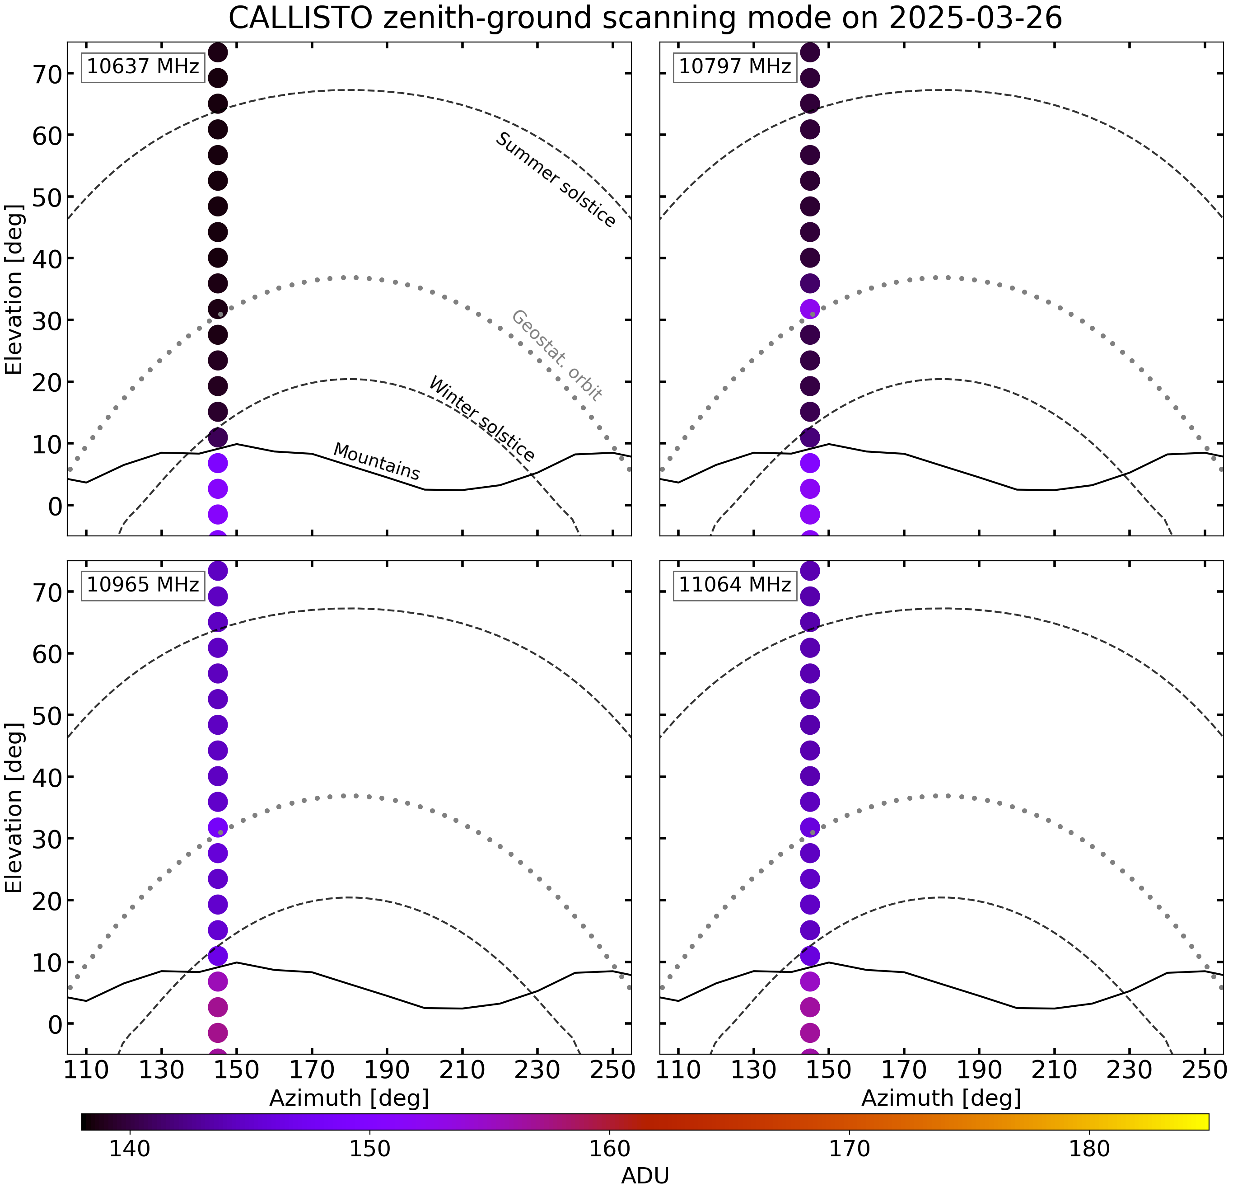
output/nightscan/scan-results/zenith-ground-scan_2025-03-26.png
