wolfidan/callisto/output/nightscan/scan-results/zenith-ground-scan_elevation_2025-03-25.png

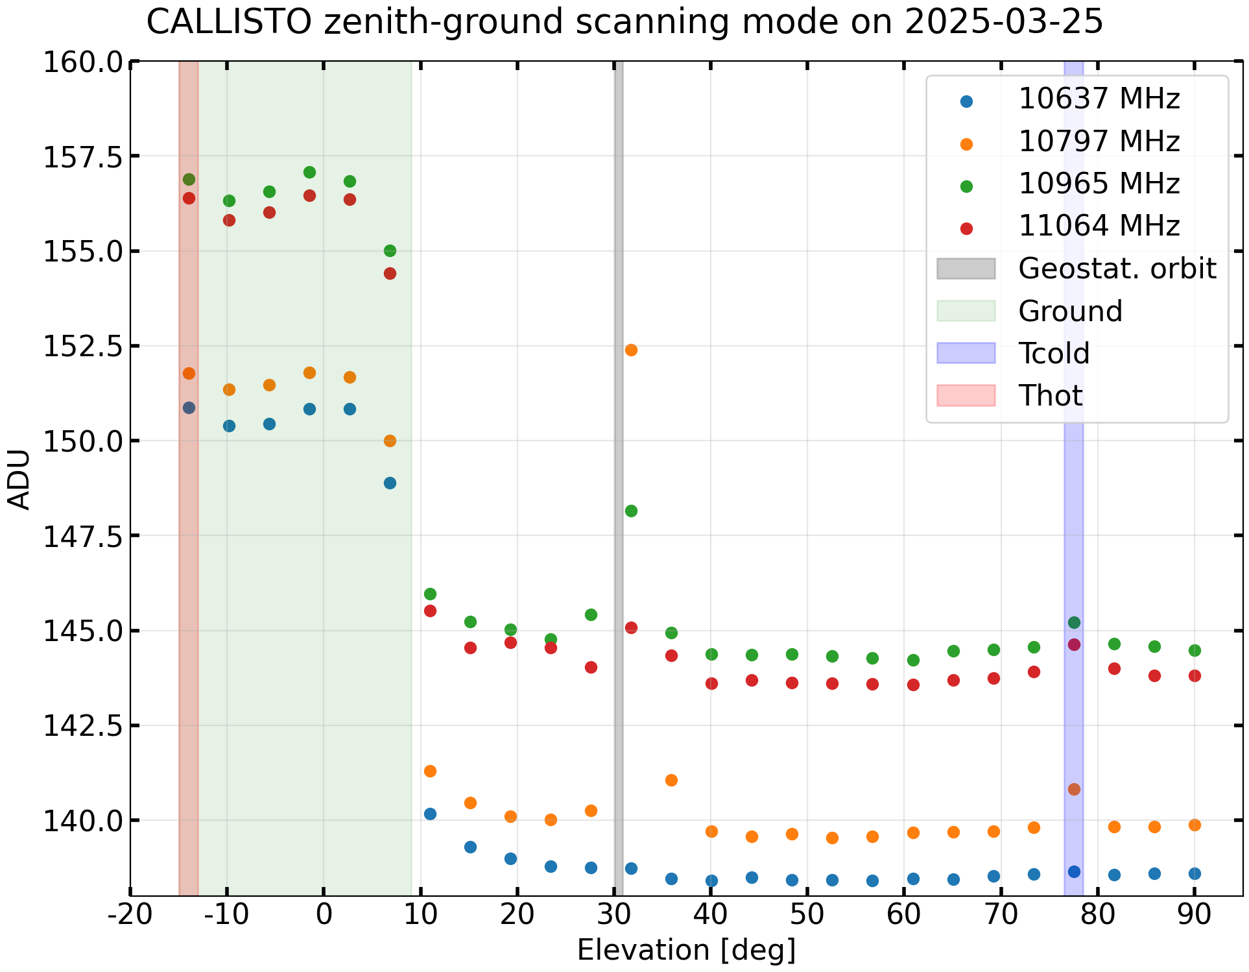
output/nightscan/scan-results/zenith-ground-scan_elevation_2025-03-25.png
