wolfidan/callisto/output/nightscan/scan-results/zenith-ground-scan_elevation_2025-04-16.png

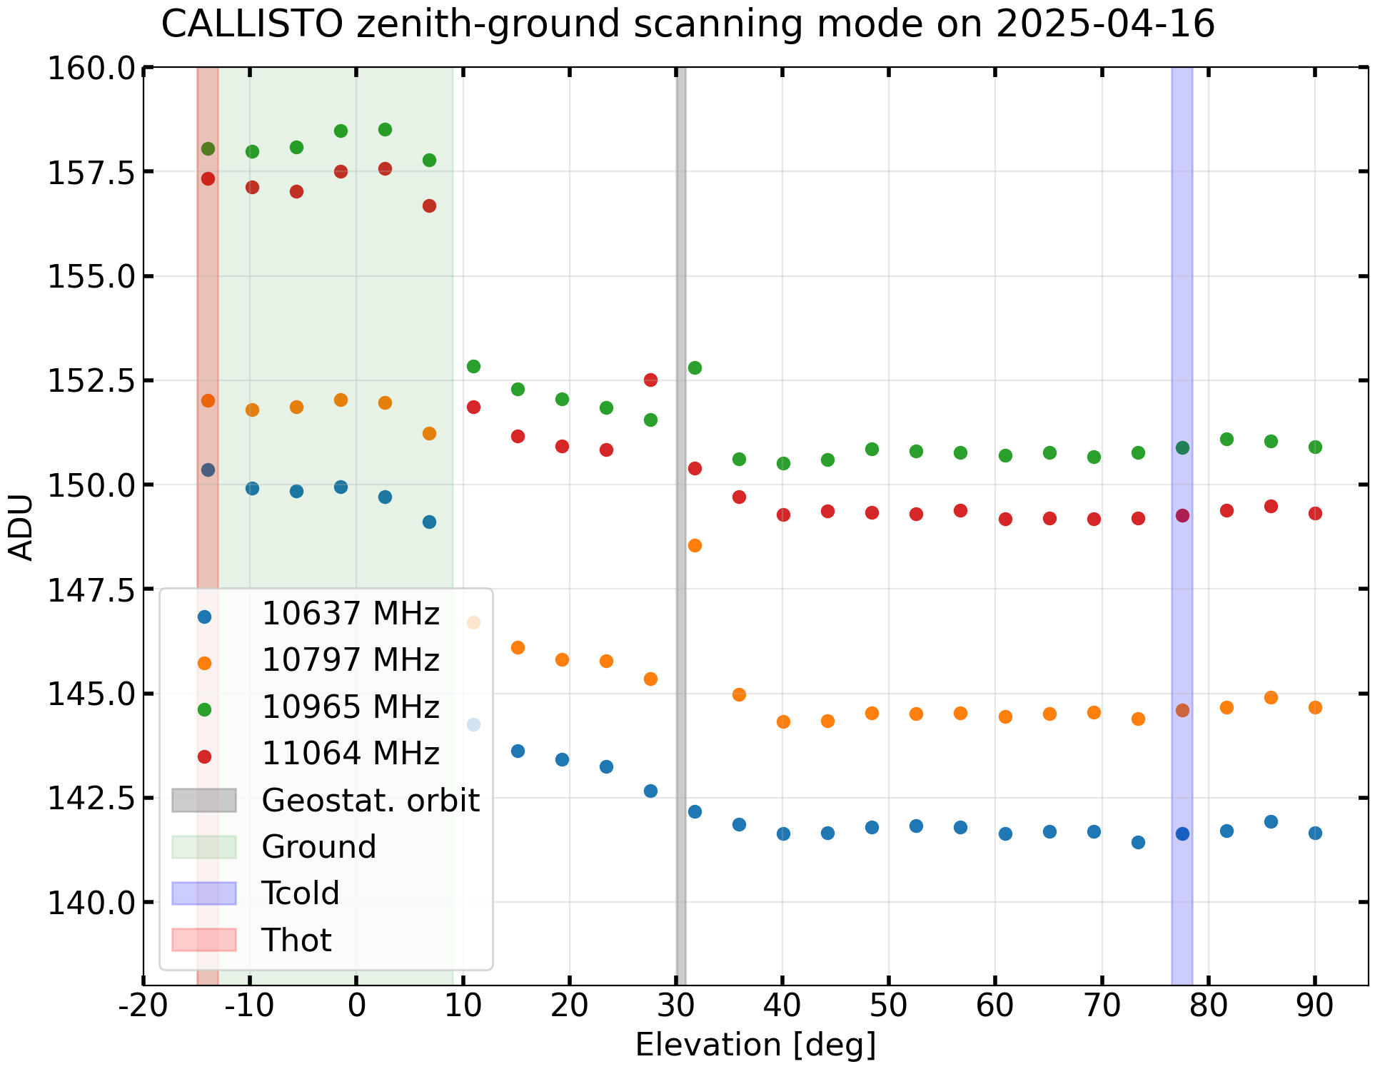
output/nightscan/scan-results/zenith-ground-scan_elevation_2025-04-16.png
