wolfidan/callisto/output/nightscan/scan-results/zenith-ground-scan_elevation_2025-05-07.png

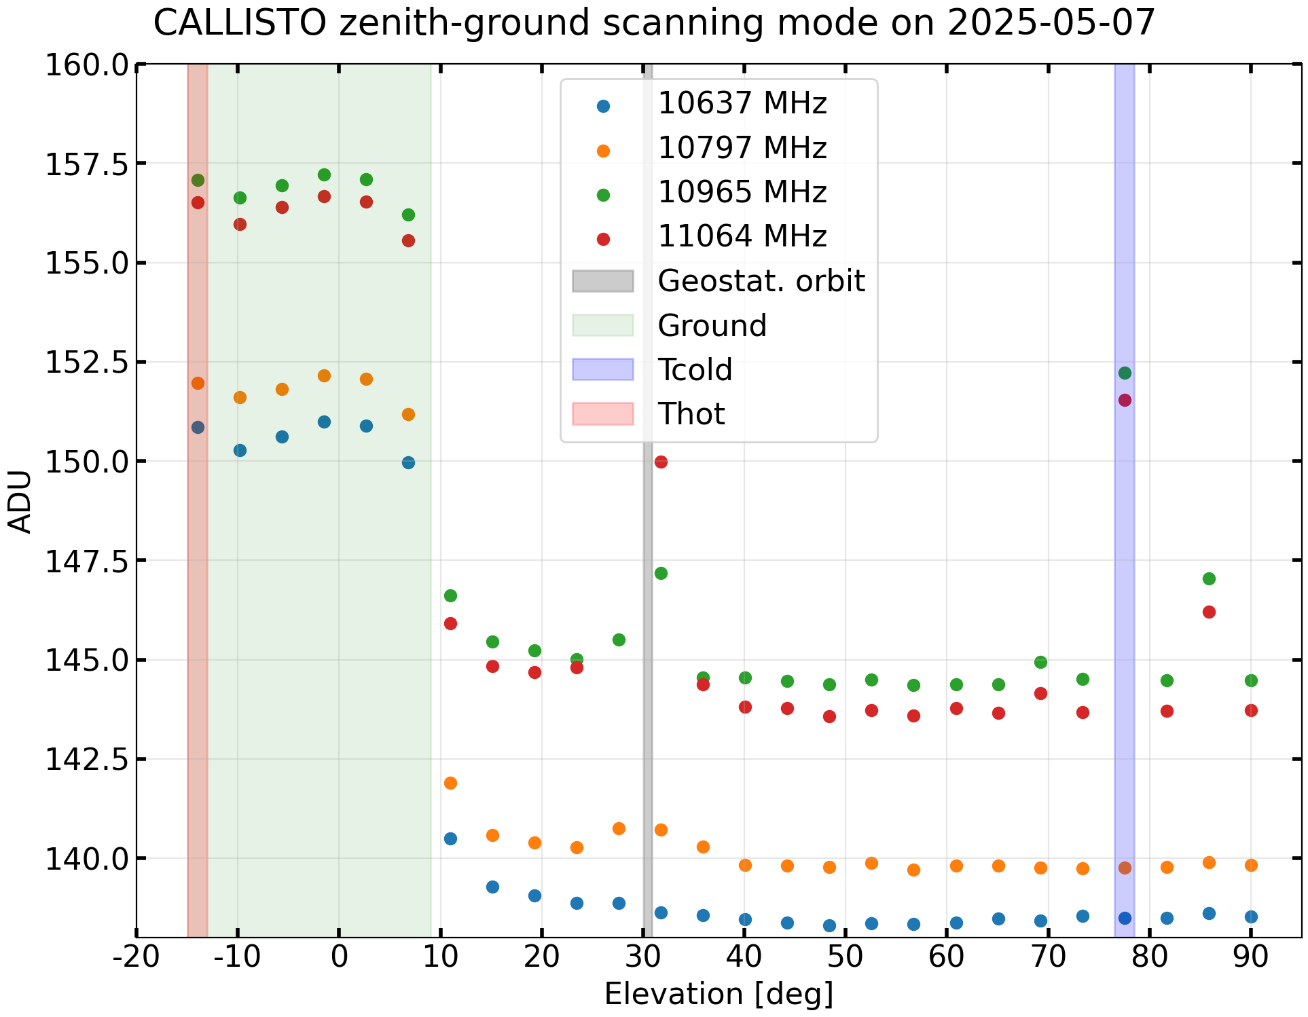
output/nightscan/scan-results/zenith-ground-scan_elevation_2025-05-07.png
