wolfidan/callisto/doc/datagram2pages3X11.pdf

## Datagram CALLISTO

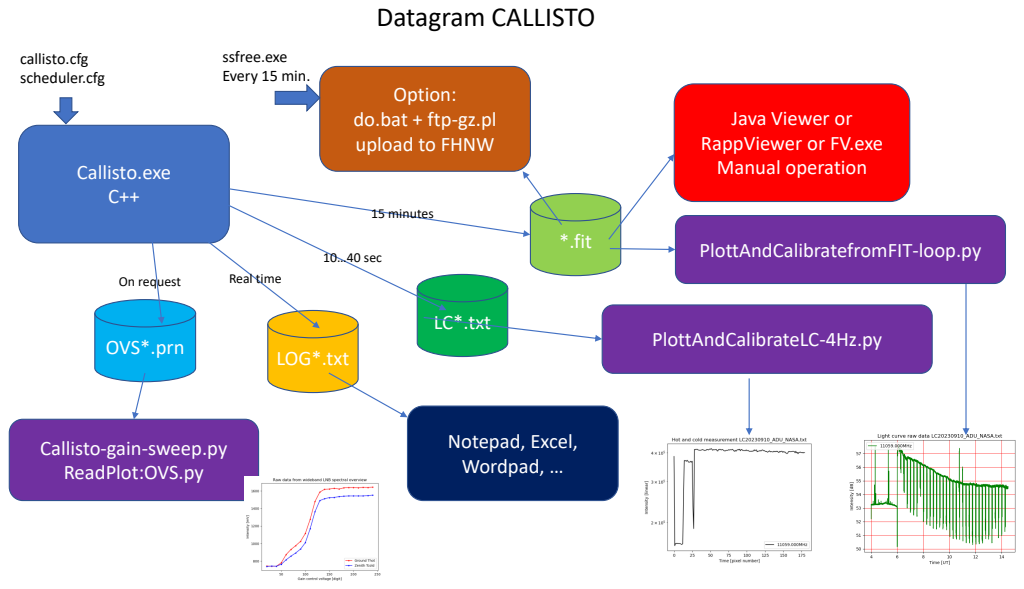
[picture p106: page 1]
Callisto.exe C++; PlottAndCalibrateLC-4Hz.py; Notepad, Excel, Wordpad, …; *.fit; LC*.txt; ssfree.exe Every 15 min.; callisto.cfg scheduler.cfg; 15 minutes; 10…40 sec; On request; Real time

Option:
do.bat + ftp-gz.pl
upload to FHNW

Java Viewer or
RappViewer or FV.exe
Manual operation

PlottAndCalibratefromFIT-loop.py

LOG*.txt OVS*.prn

Callisto-gain-sweep.py
ReadPlot:OVS.py

## Datagram DiSEqC Tracker

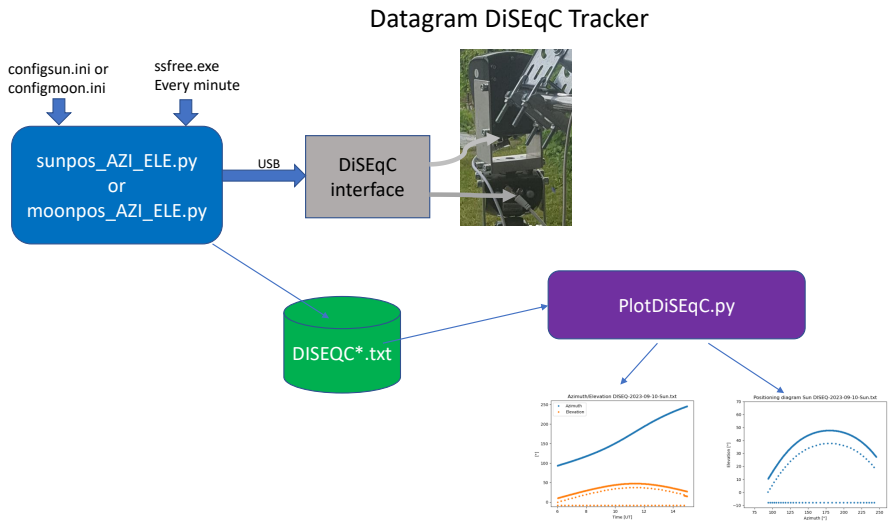
[picture p107: page 2]
sunpos_AZI_ELE.py or moonpos_AZI_ELE.py; ssfree.exe Every minute; DISEQC*.txt; PlotDiSEqC.py; DiSEqC interface; USB

configsun.ini or
configmoon.ini
