wolfidan/callisto/callisto_lib/constants.py

# Constants used throughout the library
import os
from . import PROJECT_DIR
DIR_LOG = os.path.join(PROJECT_DIR, "logs")
DIR_DATA = os.path.join(PROJECT_DIR, "data")
DIR_OUTPUT = os.path.join(PROJECT_DIR, "outputs")
DIR_CALIBRATION = os.path.join(PROJECT_DIR, "calibration")
DIR_CONFIG = os.path.join(PROJECT_DIR, "config")
