wolfidan/callisto/(commit log)

2025-04-10 Updated .gitignore to exclude ExtraTools directory
    [meteoswiss_2025-04-10.csv]
2025-04-10 Remove large files and update .gitignore
    [OVS_meteoswiss_xband_20250116_174500_01.csv, meteoswiss_2025-04-10.csv, pointing-offsets_2025.csv]
2025-04-11 Staging changes before filter-branch
    [daily-flux_2025.csv, meteoswiss_2025-04-10.csv]
2025-04-11 Daily automatic update Fri 04/11/2025
    [meteoswiss_2025-04-11.csv]
2025-04-12 Daily automatic update Sat 04/12/2025
    [daily-flux_2025.csv, meteoswiss_2025-04-11.csv, meteoswiss_2025-04-12.csv, pointing-offsets_2025.csv]
2025-04-13 Daily automatic update Sun 04/13/2025
    [daily-flux_2025.csv, meteoswiss_2025-04-12.csv, meteoswiss_2025-04-13.csv, pointing-offsets_2025.csv]
2025-04-14 Daily automatic update Mon 04/14/2025
    [daily-flux_2025.csv, meteoswiss_2025-04-13.csv, meteoswiss_2025-04-14.csv, pointing-offsets_2025.csv]
2025-04-15 Daily automatic update Tue 04/15/2025
    [daily-flux_2025.csv, meteoswiss_2025-04-14.csv, meteoswiss_2025-04-15.csv, pointing-offsets_2025.csv]
2025-04-16 Daily automatic update Wed 04/16/2025
    [daily-flux_2025.csv, meteoswiss_2025-04-15.csv, meteoswiss_2025-04-16.csv, pointing-offsets_2025.csv]
2025-04-17 Daily automatic update Thu 04/17/2025
    [daily-flux_2025.csv, meteoswiss_2025-04-16.csv, meteoswiss_2025-04-17.csv, pointing-offsets_2025.csv]
2025-04-18 Daily automatic update Fri 04/18/2025
    [daily-flux_2025.csv, meteoswiss_2025-04-17.csv, meteoswiss_2025-04-18.csv, pointing-offsets_2025.csv]
2025-04-19 Daily automatic update Sat 04/19/2025
    [daily-flux_2025.csv, meteoswiss_2025-04-18.csv, meteoswiss_2025-04-19.csv, pointing-offsets_2025.csv]
2025-04-20 Daily automatic update Sun 04/20/2025
    [daily-flux_2025.csv, meteoswiss_2025-04-19.csv, meteoswiss_2025-04-20.csv, pointing-offsets_2025.csv]
2025-04-21 Daily automatic update Mon 04/21/2025
    [daily-flux_2025.csv, meteoswiss_2025-04-20.csv, meteoswiss_2025-04-21.csv, pointing-offsets_2025.csv]
2025-04-22 Daily automatic update Tue 04/22/2025
    [daily-flux_2025.csv, meteoswiss_2025-04-21.csv, meteoswiss_2025-04-22.csv, pointing-offsets_2025.csv]
2025-04-23 Daily automatic update Wed 04/23/2025
    [daily-flux_2025.csv, meteoswiss_2025-04-22.csv, meteoswiss_2025-04-23.csv, pointing-offsets_2025.csv]
2025-04-24 Daily automatic update Thu 04/24/2025
    [daily-flux_2025.csv, meteoswiss_2025-04-23.csv, meteoswiss_2025-04-24.csv, pointing-offsets_2025.csv]
2025-04-25 Daily automatic update Fri 04/25/2025
    [daily-flux_2025.csv, meteoswiss_2025-04-24.csv, meteoswiss_2025-04-25.csv, pointing-offsets_2025.csv]
2025-04-26 Daily automatic update Sat 04/26/2025
    [daily-flux_2025.csv, meteoswiss_2025-04-25.csv, meteoswiss_2025-04-26.csv, pointing-offsets_2025.csv]
2025-04-27 Daily automatic update Sun 04/27/2025
    [daily-flux_2025.csv, meteoswiss_2025-04-26.csv, meteoswiss_2025-04-27.csv, pointing-offsets_2025.csv]
2025-04-28 Daily automatic update Mon 04/28/2025
    [daily-flux_2025.csv, meteoswiss_2025-04-27.csv, meteoswiss_2025-04-28.csv, pointing-offsets_2025.csv]
2025-04-29 Daily automatic update Tue 04/29/2025
    [daily-flux_2025.csv, meteoswiss_2025-04-28.csv, meteoswiss_2025-04-29.csv, pointing-offsets_2025.csv]
2025-04-30 Daily automatic update Wed 04/30/2025
    [daily-flux_2025.csv, meteoswiss_2025-04-29.csv, meteoswiss_2025-04-30.csv, pointing-offsets_2025.csv]
2025-05-01 Update images [skip ci]
    [daily-flux_2024.csv, daily-flux_2025.csv]
2025-05-01 Daily automatic update Thu 05/01/2025
    [daily-flux_2025.csv, meteoswiss_2025-04-30.csv, meteoswiss_2025-05-01.csv, pointing-offsets_2025.csv]
2025-05-02 Daily automatic update Fri 05/02/2025
    [daily-flux_2025.csv, meteoswiss_2025-05-01.csv, meteoswiss_2025-05-02.csv, pointing-offsets_2025.csv]
2025-05-03 Daily automatic update Sat 05/03/2025
    [daily-flux_2025.csv, meteoswiss_2025-05-02.csv, meteoswiss_2025-05-03.csv, pointing-offsets_2025.csv]
2025-05-04 Daily automatic update Sun 05/04/2025
    [daily-flux_2025.csv, meteoswiss_2025-05-03.csv, meteoswiss_2025-05-04.csv, pointing-offsets_2025.csv]
2025-05-05 Daily automatic update Mon 05/05/2025
    [meteoswiss_2025-05-04.csv, meteoswiss_2025-05-05.csv]
2025-05-05 change of webpage structure
    [daily-flux_2024.csv, daily-flux_2025.csv]
2025-05-05 add possibility to switch img with left/right btns
2025-05-06 Daily automatic update Tue 05/06/2025
    [daily-flux_2025.csv, meteoswiss_2025-05-05.csv, meteoswiss_2025-05-06.csv, pointing-offsets_2025.csv]
2025-05-07 Daily automatic update Wed 05/07/2025
    [meteoswiss_2025-05-06.csv, meteoswiss_2025-05-07.csv]
2025-05-08 Daily automatic update Thu 05/08/2025
    [meteoswiss_2025-05-07.csv]
2025-05-09 Daily automatic update Fri 05/09/2025
    [daily-flux_2025.csv, meteoswiss_2025-05-08.csv, meteoswiss_2025-05-09.csv, pointing-offsets_2025.csv]
2025-05-10 Daily automatic update Sat 05/10/2025
    [daily-flux_2025.csv, meteoswiss_2025-05-09.csv, meteoswiss_2025-05-10.csv, pointing-offsets_2025.csv]
2025-05-11 Daily automatic update Sun 05/11/2025
    [daily-flux_2025.csv, meteoswiss_2025-05-10.csv, meteoswiss_2025-05-11.csv, pointing-offsets_2025.csv]
2025-05-12 Daily automatic update Mon 05/12/2025
    [daily-flux_2025.csv, meteoswiss_2025-05-11.csv, meteoswiss_2025-05-12.csv, pointing-offsets_2025.csv]
2025-05-13 Daily automatic update Tue 05/13/2025
    [daily-flux_2025.csv, meteoswiss_2025-05-12.csv, meteoswiss_2025-05-13.csv, pointing-offsets_2025.csv]
2025-05-14 Daily automatic update Wed 05/14/2025
    [daily-flux_2025.csv, meteoswiss_2025-05-13.csv, meteoswiss_2025-05-14.csv, pointing-offsets_2025.csv]
2025-05-15 Daily automatic update Thu 05/15/2025
    [daily-flux_2025.csv, meteoswiss_2025-05-14.csv, meteoswiss_2025-05-15.csv, pointing-offsets_2025.csv]
2025-05-16 Daily automatic update Fri 05/16/2025
    [daily-flux_2025.csv, meteoswiss_2025-05-15.csv, meteoswiss_2025-05-16.csv, pointing-offsets_2025.csv]
2025-05-17 Daily automatic update Sat 05/17/2025
    [daily-flux_2025.csv, meteoswiss_2025-05-16.csv, meteoswiss_2025-05-17.csv]
2025-05-19 manual push
    [daily-flux_2025.csv, meteoswiss_2025-05-17.csv, meteoswiss_2025-05-18.csv, meteoswiss_2025-05-19.csv, pointing-offsets_2025.csv]
2025-05-19 Daily automatic update Mon 05/19/2025
    [daily-flux_2025.csv, meteoswiss_2025-05-19.csv, pointing-offsets_2025.csv]
2025-05-20 Daily automatic update Tue 05/20/2025
    [meteoswiss_2025-05-19.csv, pointing-offsets_2025.csv]
2025-05-21 Daily automatic update Wed 05/21/2025
    [daily-flux_2025.csv, meteoswiss_2025-05-20.csv, meteoswiss_2025-05-21.csv, pointing-offsets_2025.csv]
2025-05-22 manual commit
    [meteoswiss_2025-05-21.csv, meteoswiss_2025-05-22.csv]
